Hokkaido-Open-Hardware/PSC-ONE/board/PSC-ONE_Neo/README.md

# PSC-ONE Neo

[Boards](../README.md) · [Project](../../README.md)

A planned successor to the PSC-ONE prototype, with the FPGA mounted directly on the PCB. Performance, memory and peripheral details remain design goals.

## Status

Under development. This directory does not yet provide a validated build and bring-up procedure.
