Hokkaido-Open-Hardware/PSC-ONE/board/PSC-Robot/README.md

# PSC-Robot

[Boards](../README.md) · [Project](../../README.md)

A planned robotics platform for motor control, sensing and PSC-ONE edge-AI demonstrations. The project overview includes the proposed balancing-robot demo.

## Status

Under development. This directory does not yet provide a validated build and bring-up procedure.
