Hokkaido-Open-Hardware/PSC-ONE/docs/images/PSC_RV32_V1_RTL.odp

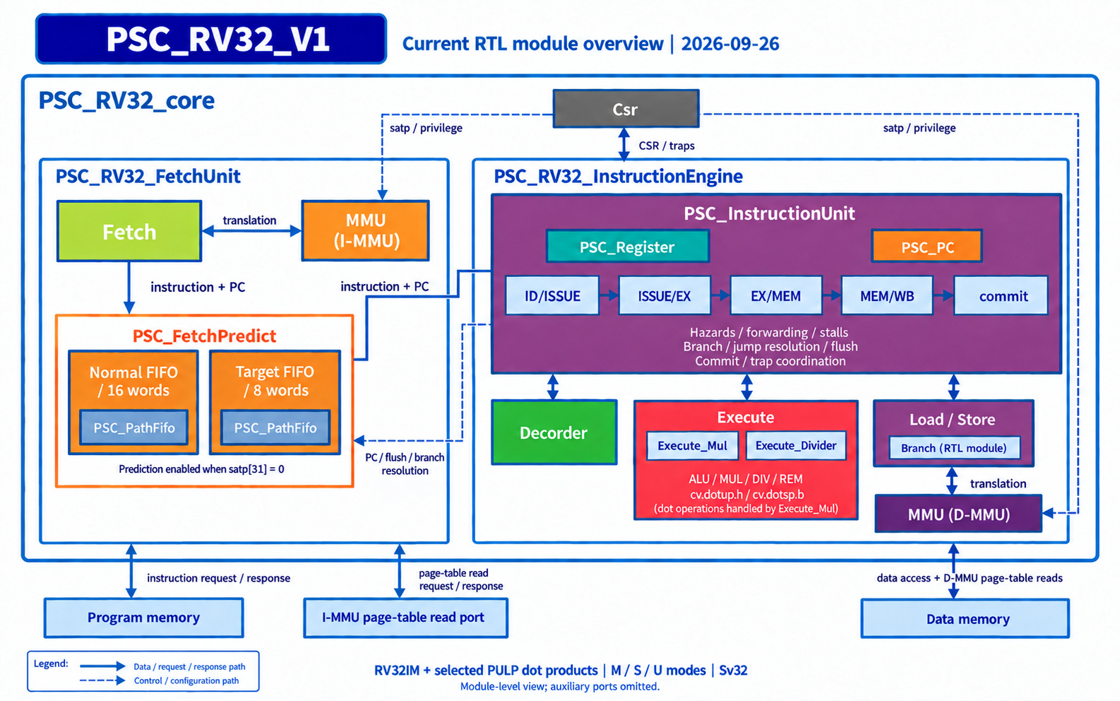
[picture p26: figure]
PSC_RV32_V1 current RTL module overview Original JPG embedded as a single image. Diagram labels and lines are not individually editable.
