Hokkaido-Open-Hardware/PSC-ONE/docs/PSC-ONE_SpecSheet.pdf

# PRELIMINARY

# PSC_ONE_Ver1.00

### PSC_ONE Chip Rev.1.00

Data Sheet
Rev.0.8 — Preliminary
QPSC Devices, Inc.
2026-06-02

4.5 2
目次

# PRELIMINARY

## 1 概要（Overview）

PSC_ONE は、QPSC-Design が開発するオープンソースのフルスタック RISC-V SoC プラットフォームである。 本システムは、独自開発の RV32ISP パイプライン CPU、Sv32 MMU、SDRAM コントローラ、キャッシュシステ ム、SD カードインタフェース、LCD コントローラ、および SynapEngine AI アクセラレータを単一アーキテクチャに 統合している。
PSC_ONE は専用 OS である PSC_OS を搭載し、SD カードからカーネルおよびユーザアプリケーションをロード して実行可能である。
ハードウェアとソフトウェアを一体開発できる教育・研究・組込み AI・ロボット制御向け SoC プラットフォームと して設計されている。

## 2 特長（Features）

- RV32ISP 32-bit RISC-V Pipeline CPU
- Sv32 MMU (Virtual Memory Support)
- PSC_OS Operating System
- SDR SDRAM Controller
- AXI4 Memory Infrastructure
- Data / Instruction Cache
- SD Card Boot Support (SPI Mode)
- SynapEngine AI Accelerator
- 2×2 INT8 Systolic Array
- UART Interface
- LCD Controller
- Memory Mapped I/O Architecture
- FPGA Verified Implementation

## 3 アプリケーション（Applications）

- Embedded AI Systems
- Edge Computing
- Robotics Control
- FPGA Education
- Operating System Research
- RISC-V Architecture Research
- AI Accelerator Development
- Computer Architecture Education

## 4 ブロック図（Block Diagram）

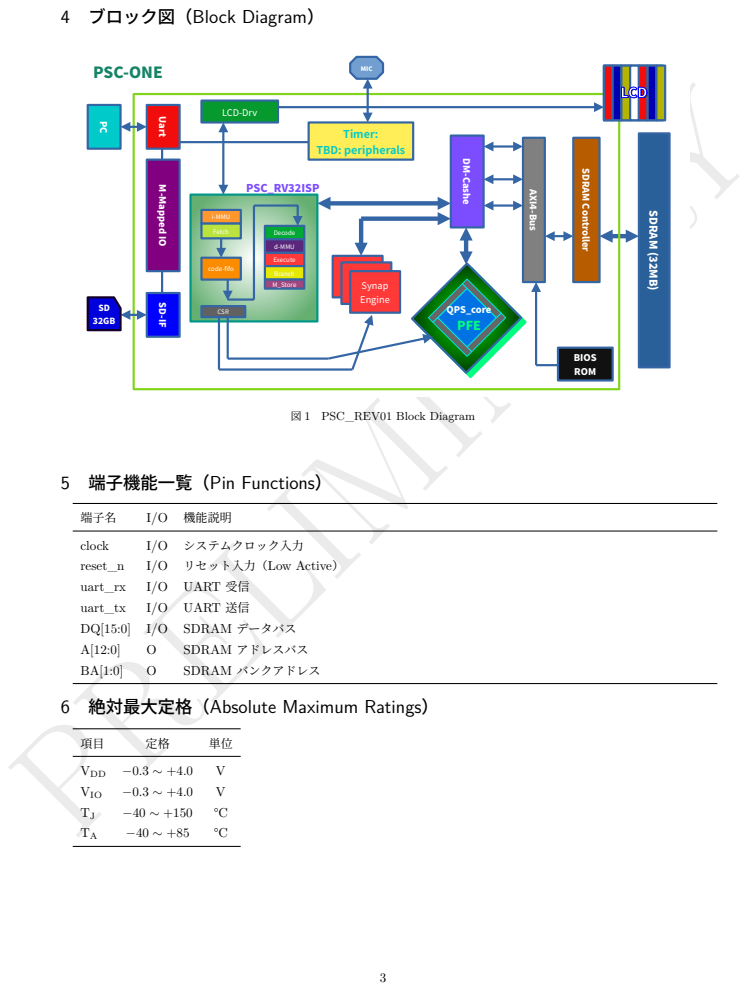
[picture p33: page 3]
PRELIMINARY PSC-ONE; t r olle; Fetch; Decode; Execute Branch M_Store; i-MMU; d-MMU; Synap Engine; AXI4-B; BIOS ROM; LCD-Drv; LCD LCD; code-fifo; PSC_RV32ISP; Timer: TBD: peripherals; CSR; MIC; QPS_core PFE; 図 1 PSC_REV01 Block Diagram; 端子名; I/O 機能説明; clock; I/O システムクロック入力; reset_n; I/O リセット入力（Low Active）; SDRAM アドレスバス; SDRAM バンクアドレス; VDD; VIO

5 端子機能一覧（Pin Functions）

uart_rx I/O UART 受信
uart_tx I/O UART 送信
DQ[15:0] I/O SDRAM データバス
6 絶対最大定格（Absolute Maximum Ratings）

# PRELIMINARY

## 7 推奨動作条件（Recommended Operating Conditions）

項目 | 最小 典型 | 最大
VDD | 3.0 | 3.3 | 3.6
VIO | 3.0 | 3.3 | 3.6
CLK 周波数 | – | – | 133 MHz
動作温度 TA | -40 | 25 | 85
Note: Conditions equivalent to Tang Nano 25K Primer.

## 8 電気的特性（Electrical Characteristics）

項目 | 最小 典型 | 最大
ICC（READ） | – | 60 80 mA
ICC（WRITE） – | 70 95 mA

## 9 発注情報（Ordering Information）

型番 | パッケージ
PSC1234-QFP48 48-pin QFP
PSC1234-BGA64 BGA64
