Hokkaido-Open-Hardware/PSC-ONE/ip/README.md

<p align="center">
  <a href="https://github.com/QPSC-Design/PSC-ONE">
    PSC-ONE Logo
  </a>
</p>

# Intellectual Property (IP)

[PSC-ONE](../README.md) · [Documentation](../docs/README.md)

This directory contains intellectual property related materials for the PSC-ONE project, including invention notes, prior art research, and patent draft documents.

At present, **two patent applications are planned** based on technologies developed within the PSC-ONE project.

The details of these applications have not yet been publicly disclosed.

Contents of this directory may be updated as development progresses and patent filings are completed.
