Hokkaido-Open-Hardware/PSC-ONE/board/PSC-ONE/README.md

# PSC-ONE Design

[PSC-ONE](../../README.md) · [Documentation](../../docs/README.md)

The current PSC-ONE prototype hardware.\

PSC-ONE board

<!-- contents -->
- [Purpose](#purpose)
- [Features](#features)
- [Getting Started](#getting-started)
- [License](#license)
<!-- /contents -->

## Purpose

PSC-ONE is a hardware evaluation and demonstration platform for the PSC project.

The board is designed to verify and validate the functionality of the PSC CPU, operating system, memory subsystem, peripherals, and AI acceleration technologies in a real hardware environment.

It also serves as a demonstration platform for various embedded applications, including:

- Voice recognition
- AI inference
- Graphics and display control
- Sensor integration
- Real-time embedded systems

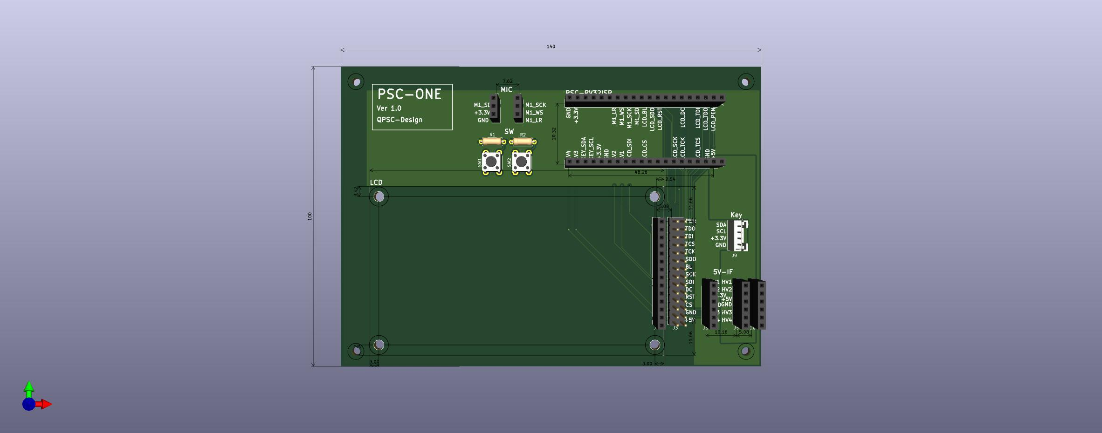
[picture p37: board/PSC-ONE/mechanical/PSC-ONE.3D_final.jpg]
PSC-ONE.3D final


## Features

- Custom PSC RISC-V CPU
- PSC-OS operating system support
- SDRAM memory interface
- LCD display interface
- Optional touch panel support
- SD card storage interface
- UART debugging console
- GPIO expansion
- AI accelerator integration support

## Getting Started

### Program the FPGA

Build the FPGA bitstream and program the PSC-ONE board using the Gowin Programmer.

After successful programming, connect:

* UART console
* SD card containing PSC-OS images
* LCD module (optional)

### Prepare the SD Card

Match the SD layout to the bootloader in the FPGA image. Two flows exist:

| Bootloader | SD layout |
| --- | --- |
| [FAT32 loader](../../software/os/src/boot/bootloader_fat32.c) | `KERNEL.MEM` and `USER.MEM` in the FAT32 root |
| [Legacy raw-image writer](../../hardware/bootloader/Makefile) | `kernel.img` at sector 100, `user.img` at sector 300 |

The raw-image writer currently hard-codes `/dev/sdc`; it does not accept a
`/dev/sdX` placeholder or automatically select a card. Inspect the actual device
and the selected bootloader before using that writer. The historical log below
belongs to the earlier raw-sector flow and is not a current layout specification.

Build the FAT32 bootloader from the repository root with the OS Makefile's
`fpga_fat32_boot` target (see that [Makefile](../../software/os/Makefile) for
available build targets and outputs).

### Boot PSC-OS

1. Insert the SD card into PSC-ONE.
2. Power on the board.
3. Open the UART console.

The bootloader loads:

1. `kernel.img` from the SD card into SDRAM
2. `user.img` from the SD card into SDRAM
3. Transfers control to PSC-OS

Historical boot log (June 2026; addresses and image sizes are build-dependent):

<details>
<summary>Show the full recorded boot log</summary>

```text
boot start

=== PSC random memory RW test start ===
[mem_check] range 00400000 - 00800000
[mem_check] access count=00000064
[mem_check] OK

=== PSC bootloader start ===
CTRL=0000000A
SD INIT start
LOAD: LBA=00000064 count=00000024 -> addr=00200000
RD[00000000] = 00256537
RD[00000004] = B1450513
RD[00000008] = 00050113
RD[0000000C] = 5000106F
RD[00000010] = 100005B7
RD[00000014] = 0085A603
RD[00000018] = 00167613
RD[0000001C] = 00060663
RD[00000020] = 00000013
RD[00000024] = FF1FF06F
RD[00000028] = 00A5A023
RD[0000002C] = 00008067
RD[00000030] = 100005B7
RD[00000034] = 0085A603
RD[00000038] = 00167613
RD[0000003C] = 00060663
WR[00000000] = 00256537
WR[00000004] = B1450513
WR[00000008] = 00050113
WR[0000000C] = 5000106F
WR[00000010] = 100005B7
WR[00000014] = 0085A603
WR[00000018] = 00167613
WR[0000001C] = 00060663
WR[00000020] = 00000013
WR[00000024] = FF1FF06F
WR[00000028] = 00A5A023
WR[0000002C] = 00008067
WR[00000030] = 100005B7
WR[00000034] = 0085A603
WR[00000038] = 00167613
WR[0000003C] = 00060663
  loaded sector 00000000 / 00000024
RD[00000000] = 04412883
RD[00000004] = 04812403
RD[00000008] = 04C12483
RD[0000000C] = 05012903
RD[00000010] = 05412983
RD[00000014] = 05812A03
RD[00000018] = 05C12A83
RD[0000001C] = 06012B03
RD[00000020] = 06412B83
RD[00000024] = 06812C03
RD[00000028] = 06C12C83
RD[0000002C] = 07012D03
RD[00000030] = 07412D83
RD[00000034] = 07812103
RD[00000038] = 10200073
RD[0000003C] = FCC10113
WR[00000000] = 04412883
WR[00000004] = 04812403
WR[00000008] = 04C12483
WR[0000000C] = 05012903
WR[00000010] = 05412983
WR[00000014] = 05812A03
WR[00000018] = 05C12A83
WR[0000001C] = 06012B03
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
002000d0: 93 85 65 d2 13 06 90 08  97 10 00 00 e7 80 80 6d  |..e............m|
002000e0: 6f 00 00 00 13 05 04 00  93 05 00 00 97 10 00 00  |o...............|
002000f0: e7 80 80 5a 13 05 04 00  83 20 c1 00 03 24 81 00  |...Z..... ...$..|
PSC_OS Boot Start.........
--- memset ---

+--------------------------------------------------+
|                    PSC_OS                        |
|            Minimal RISC-V Kernel Boot            |
+--------------------------------------------------+
| Build : Jun  6 2026 06:45:18
| CPU   : RV32 (Supervisor mode)
| MMU   : SV32
| UART  : SBI console or
| UART  : MMIO console
| CMD   : hello, primes, dump, sa_start
| quit  : Ctl+A C. q.
+--------------------------------------------------+
--- create_process_1 ---
---- kernel map start. ----
---- MMIO map start. ----
---- SA core address map start. ----
---- SA core data address map start. ----
---- SA core data wb address map start. ----
---- SD-Card IF address map start. ----
create_process_End
--- create_process_2 ---
---- kernel map start. ----
---- MMIO map start. ----
---- SA core address map start. ----
---- SA core data address map start. ----
---- SA core data wb address map start. ----
---- SD-Card IF address map start. ----
---- user image map start. ----
---- user stack map start. ----
create_process_End
--- yield ---
shell start.
PSC_OS> 

```

</details>

The `PSC_OS>` prompt indicates that this recorded run reached the shell.

## License

Hardware design files, schematics, PCB layouts, and related documentation are licensed under CERN-OHL-S v2.

Copyright (c) 2026 QPSC-Design
