Hokkaido-Open-Hardware/PSC-ONE/board/PSC-ONE_Neo/PSC_ONE_Neo_Board.jpg

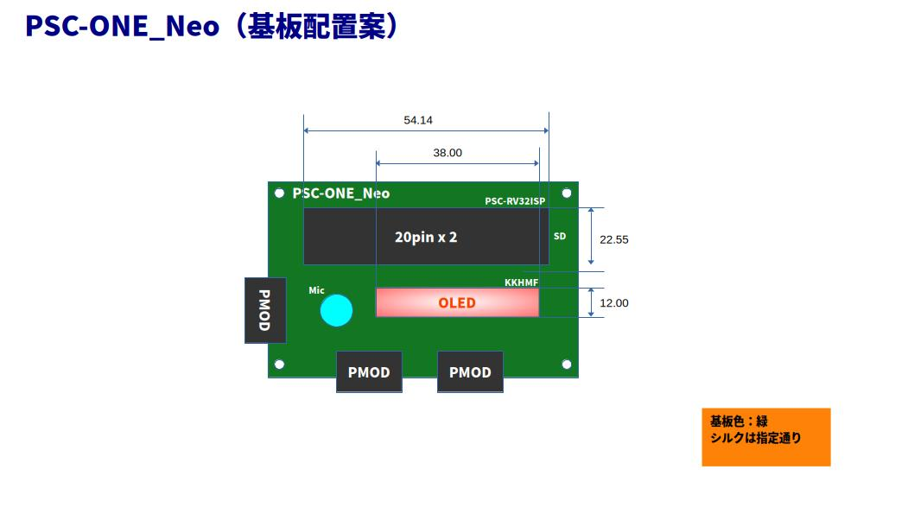
board/PSC-ONE_Neo/PSC_ONE_Neo_Board.jpg
