Hokkaido-Open-Hardware/PSC-ONE/docs/images/OMMF2026_exhibition_plan.jpg

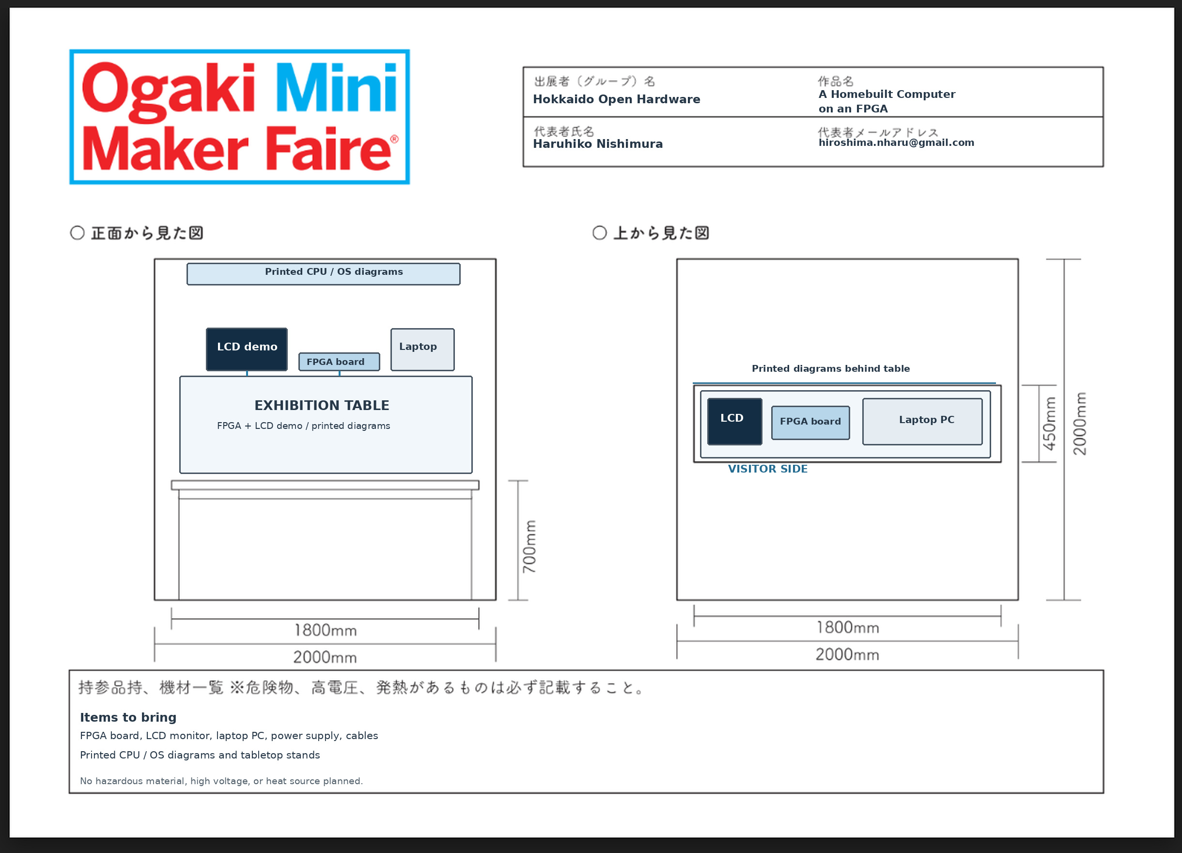
docs/images/OMMF2026_exhibition_plan.jpg
