Hokkaido-Open-Hardware/PSC-ONE/docs/images/PSC-ONE_RedBoard.png

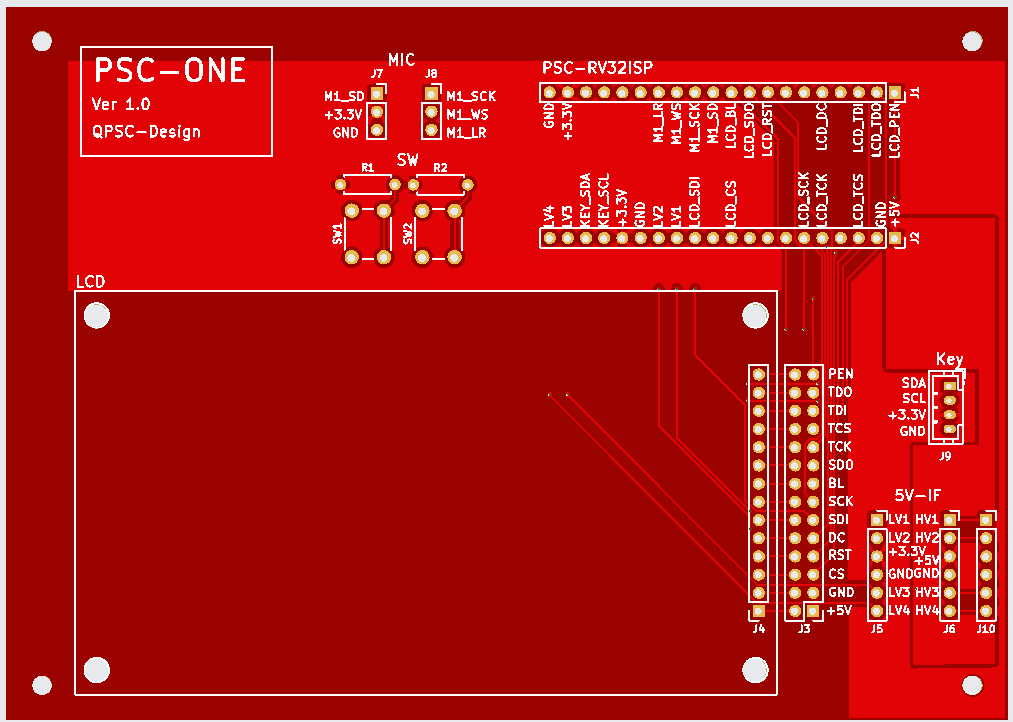
docs/images/PSC-ONE_RedBoard.png
