Hokkaido-Open-Hardware/PSC-ONE/docs/images/PSC_FPGA_SD_Card.jpg

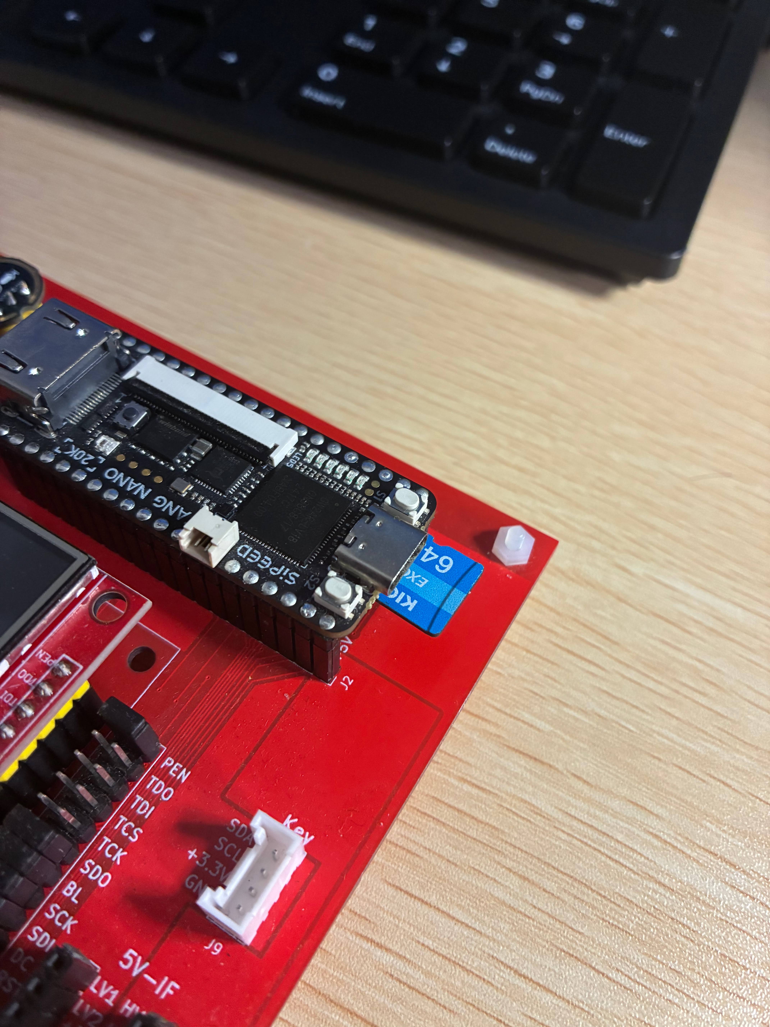
docs/images/PSC_FPGA_SD_Card.jpg
