Hokkaido-Open-Hardware/PSC-ONE/docs/images/PSC_LCD_Demo.jpg

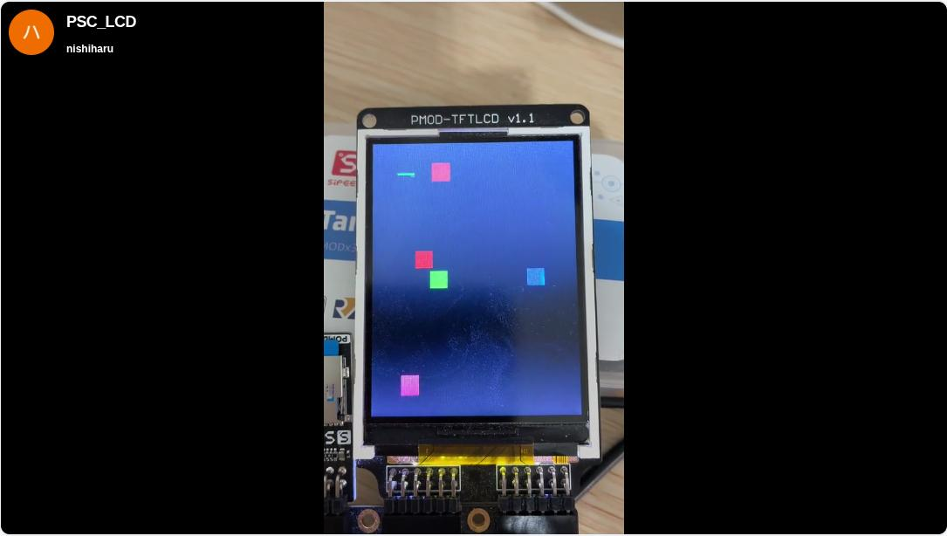
docs/images/PSC_LCD_Demo.jpg
