Hokkaido-Open-Hardware/PSC-ONE/docs/images/PSC_ONE_CPU_Block.jpg

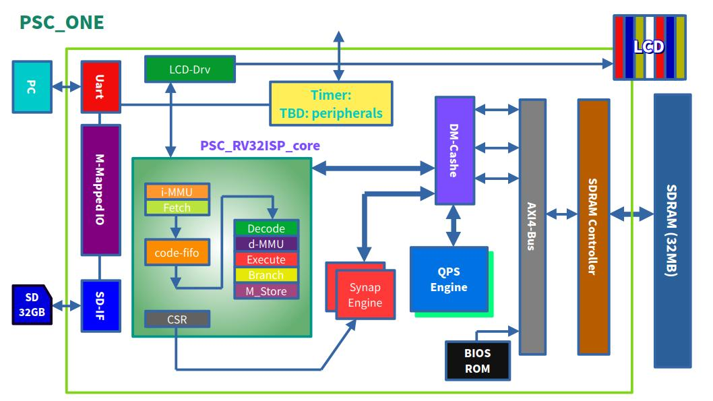
docs/images/PSC_ONE_CPU_Block.jpg
