Hokkaido-Open-Hardware/PSC-ONE/docs/images/PSC_ONE_DMA_Block.jpg

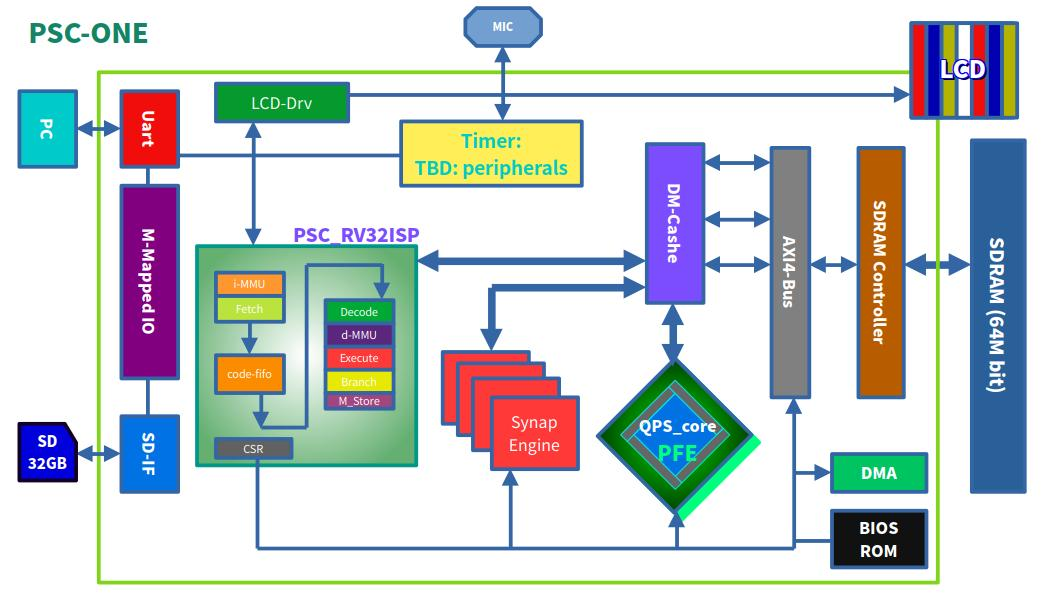
docs/images/PSC_ONE_DMA_Block.jpg
