Hokkaido-Open-Hardware/PSC-ONE/docs/images/PSC_ONE_voice_anime.png

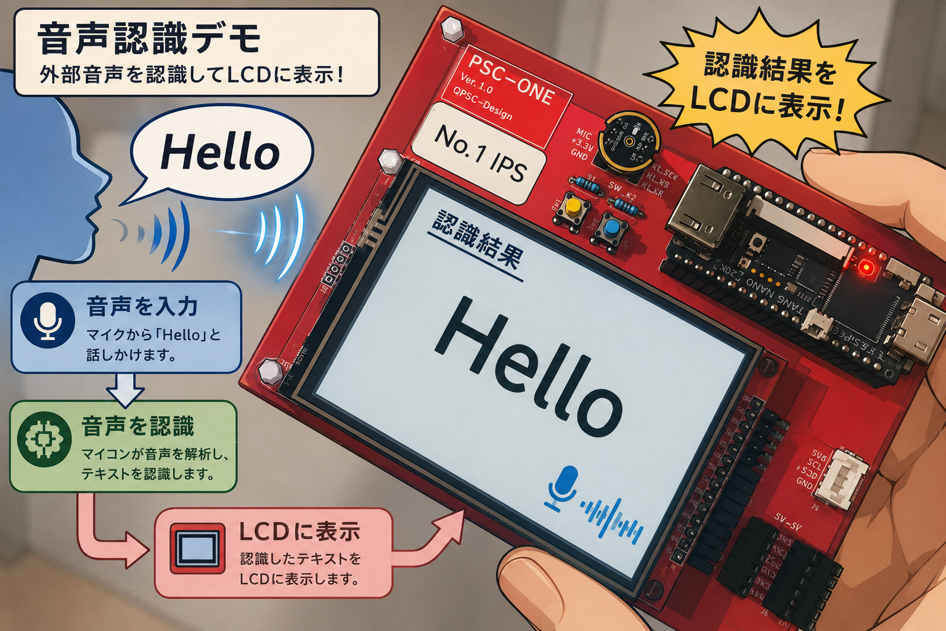
docs/images/PSC_ONE_voice_anime.png
