Hokkaido-Open-Hardware/PSC-ONE/docs/images/PSC_ONE_voice_anime_jp.png

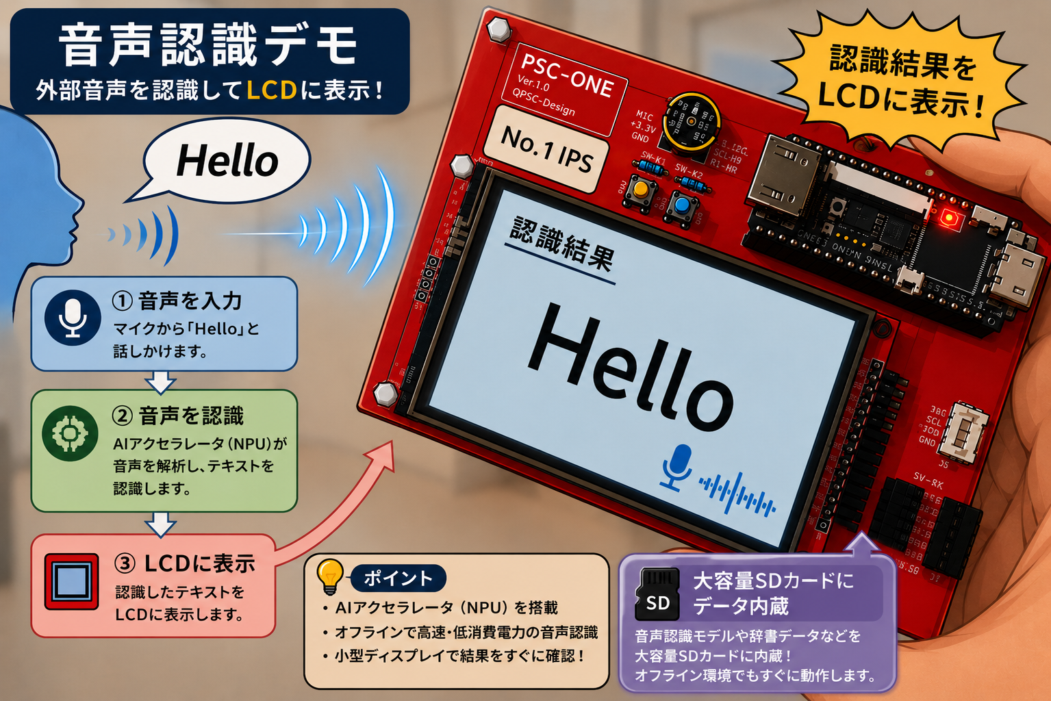
docs/images/PSC_ONE_voice_anime_jp.png
