Hokkaido-Open-Hardware/PSC-ONE/docs/images/PSC_SD_Boot.jpg

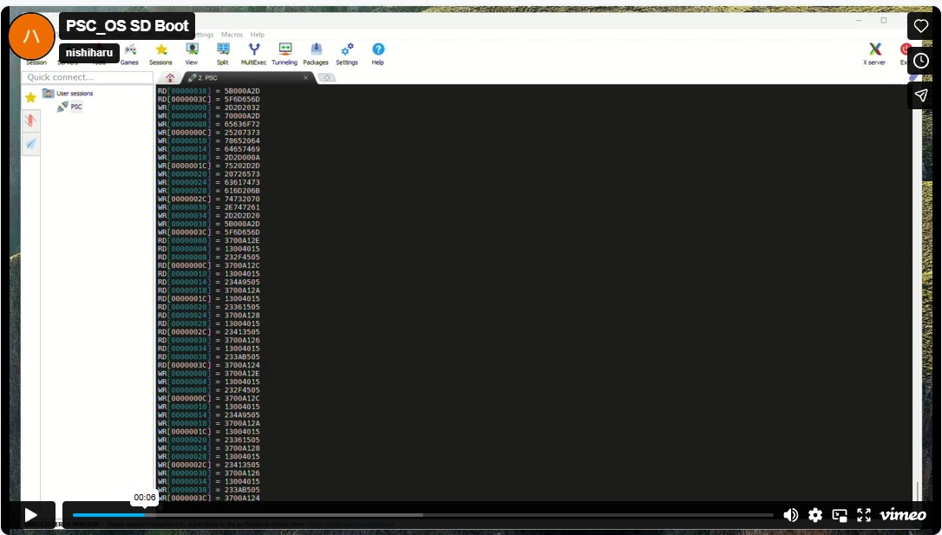
docs/images/PSC_SD_Boot.jpg
