Hokkaido-Open-Hardware/PSC-ONE/docs/PSC_OS.jpg

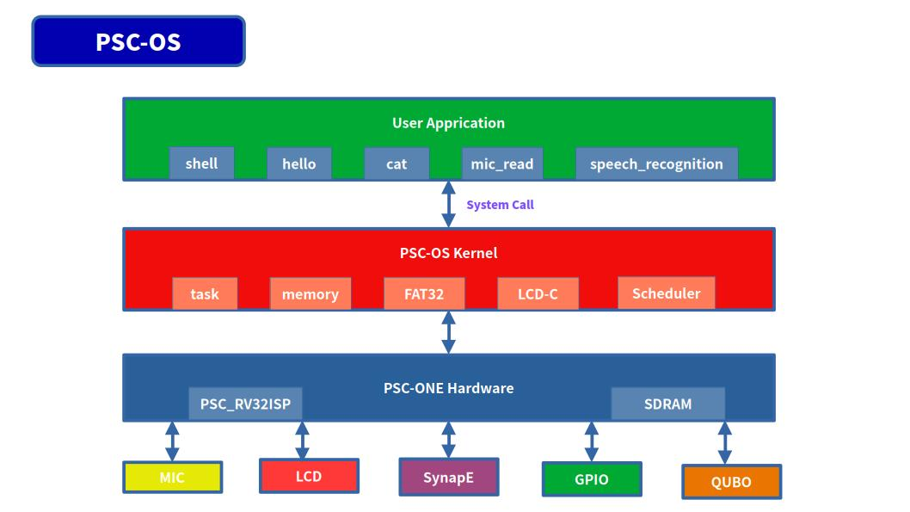
docs/PSC_OS.jpg
