Hokkaido-Open-Hardware/PSC-ONE/docs/PSC_OS_ChatGPT.png

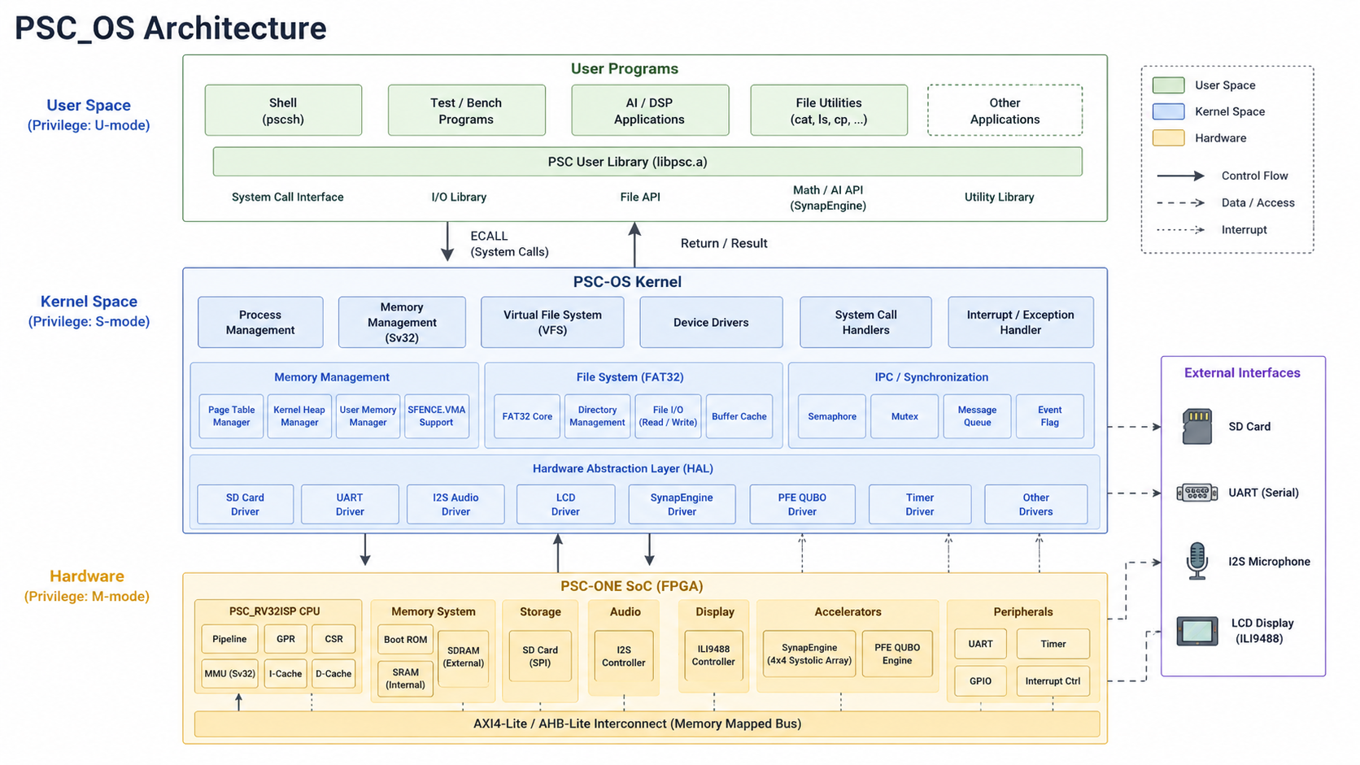
docs/PSC_OS_ChatGPT.png
