Hokkaido-Open-Hardware/PSC-ONE/hardware/rtl/soc/npu/docs/images/PSC_SynapEngine.jpg

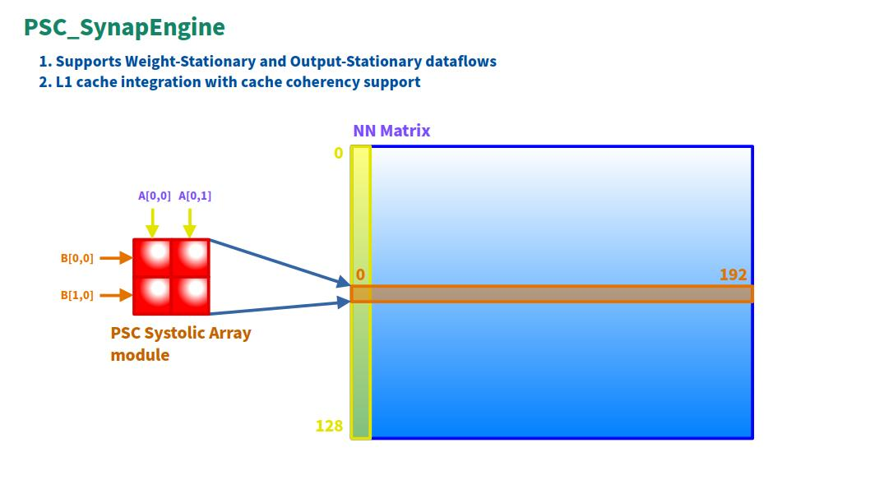
hardware/rtl/soc/npu/docs/images/PSC_SynapEngine.jpg
