Hokkaido-Open-Hardware/PSC-ONE/hardware/sim/log_yosys/yosys_cell_breakdown.png

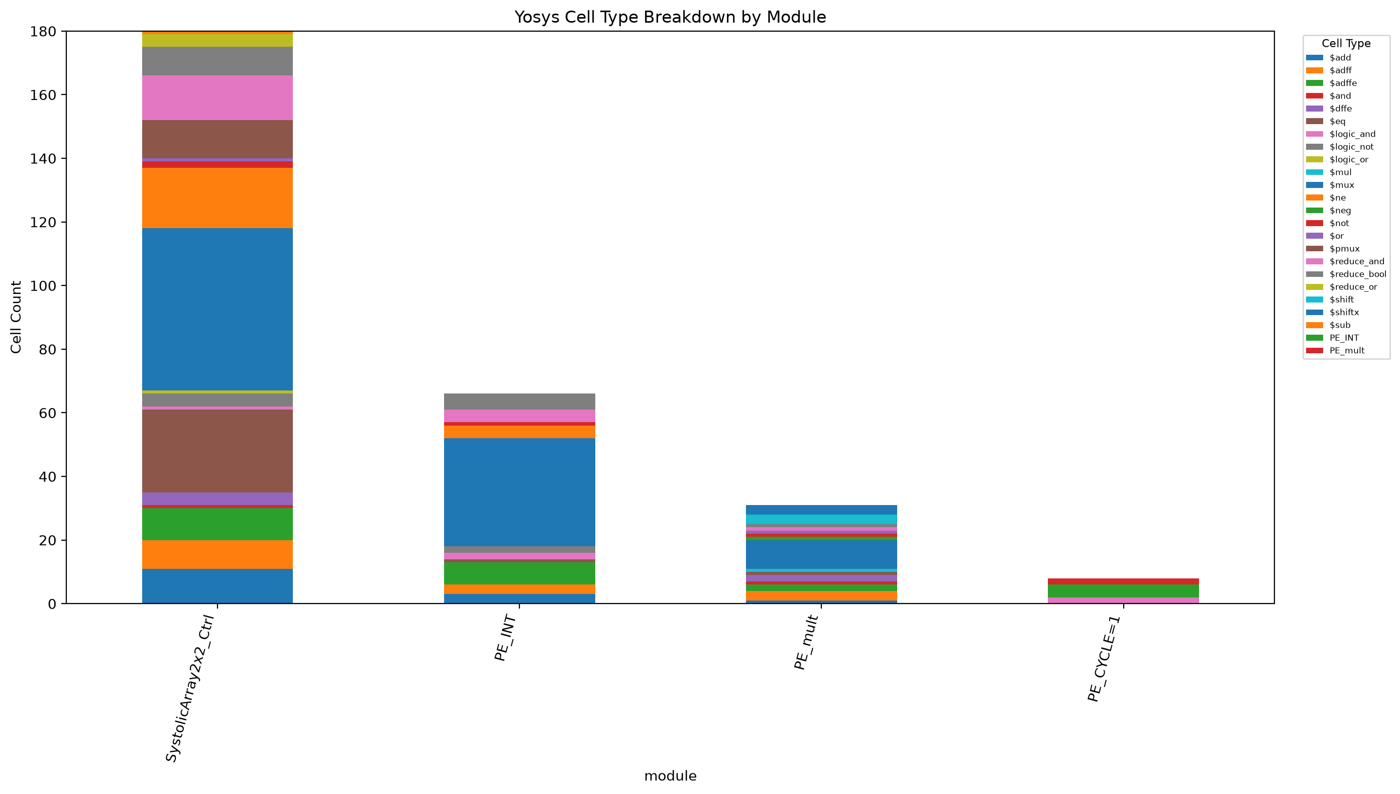
hardware/sim/log_yosys/yosys_cell_breakdown.png
