Hokkaido-Open-Hardware/PSC-ONE/hardware/sim/log_yosys/yosys_module_cells.png

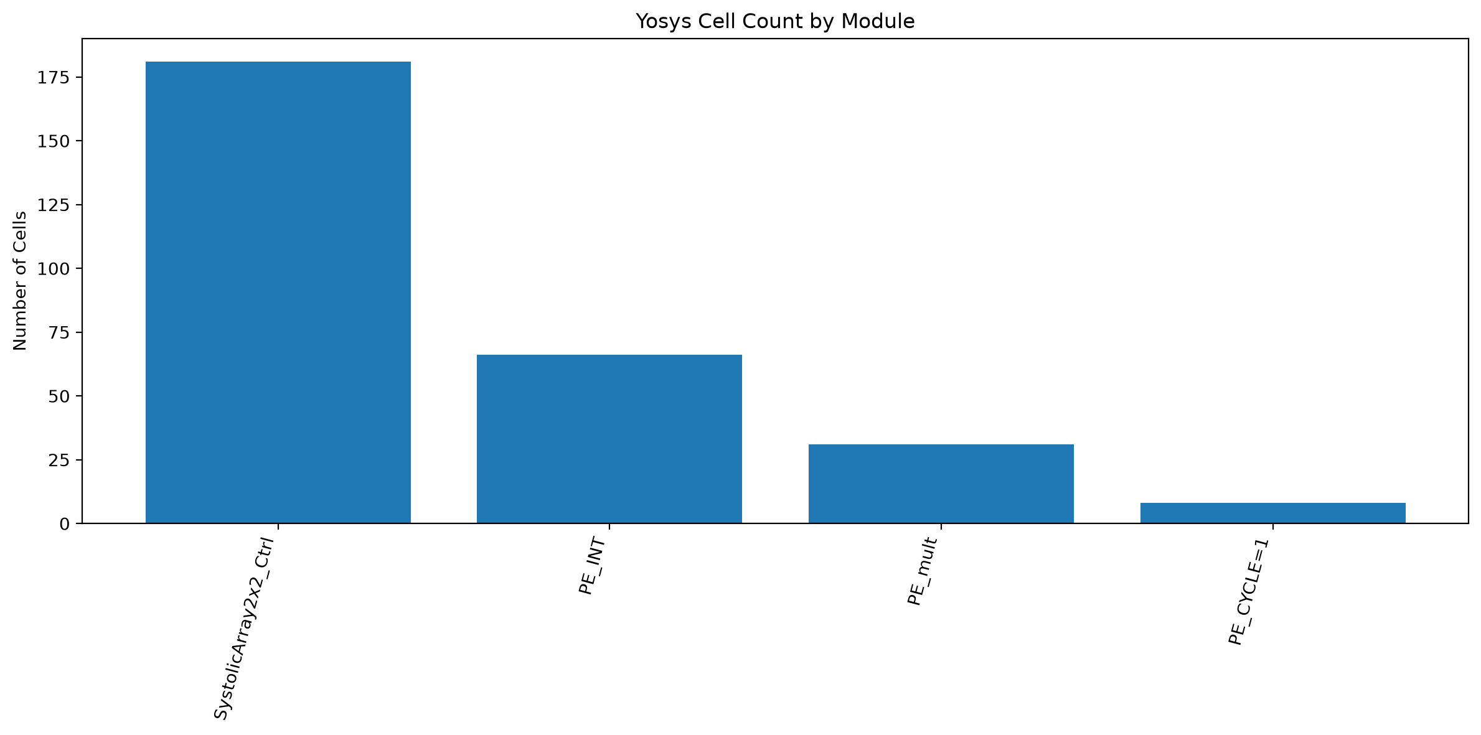
hardware/sim/log_yosys/yosys_module_cells.png
