Hokkaido-Open-Hardware/PSC-ONE/docs/getting-started.md

# Getting Started with PSC-ONE

This guide explains the basic steps required to build, simulate, and run **PSC-ONE** on a **Tang Nano 20K** FPGA board.

PSC-ONE is an experimental FPGA-based SoC consisting of a custom RISC-V CPU (**PSC_RV32**), PSC-OS, external SDRAM, peripherals, and the **PSC-NPU / SynapEngine** hardware accelerator.

The recommended procedure is:

1. Set up the simulation environment and confirm that the CPU tests pass.
2. Install Gowin EDA.
3. Create a Tang Nano 20K FPGA project and add the PSC-ONE RTL sources and CST constraints.
4. Compile the FPGA design.
5. Prepare an SD card containing `kernel.mem` and `user.mem`.
6. Connect a UART terminal.
7. Configure the Tang Nano 20K from Gowin EDA.
8. Confirm that PSC-OS boots.

The first goal is simply to get the following prompt:

```text
PSC_OS>
```

---

# 1. Requirements

## Hardware

The minimum hardware required to run PSC-ONE is:

* Tang Nano 20K FPGA board
* USB cable
* microSD card
* PC for Gowin EDA and UART communication

Additional peripherals such as the I2S microphone and LCD are not required for the initial boot test.

## Software

The development environment requires:

* Git
* Make
* Verilator
* Python 3
* cocotb
* RISC-V GCC toolchain
* Gowin EDA
* UART terminal software

A Linux environment is recommended for simulation and software development.

Gowin EDA can be used to synthesize, place-and-route, generate the FPGA bitstream, and configure the Tang Nano 20K.

---

# 2. Get the Source Code

Clone the PSC-ONE repository:

```bash
git clone https://github.com/QPSC-Design/PSC-ONE.git
cd PSC-ONE
```

The important directories are approximately:

```text
PSC-ONE/
├── docs/
├── hardware/
│   ├── rtl/
│   │   └── top/
│   │       └── PSC_ONE_Chip.v
│   └── sim/
├── software/
│   └── os/
└── README.md
```

The top-level FPGA design is:

```text
hardware/rtl/top/PSC_ONE_Chip.v
```

PSC-ONE is primarily implemented in Verilog/SystemVerilog.

---

# 3. Set Up the Simulation Environment

Before using the FPGA board, first confirm that the PSC_RV32 CPU operates correctly in simulation.

Move to the simulation directory:

```bash
cd hardware/sim
```

Set up the environment required by the `Makefile.cpu` family of tests.

The simulation environment uses tools such as:

```text
Verilator
Python
cocotb
RISC-V GCC toolchain
Make
```

Run the CPU tests provided by the `Makefile.cpu` environment.

The exact target may depend on the current version of the repository, so check the available targets in `Makefile.cpu` and related Makefiles.

The important point at this stage is that the CPU test suite completes successfully with:

```text
PASS
```

Do not proceed to FPGA debugging until the basic CPU tests pass in simulation.

This separates RTL/software problems from FPGA board, pin assignment, SD card, and UART problems.

---

# 4. Run PSC-OS in Simulation

It is also recommended to confirm that PSC-OS boots in RTL simulation before programming the FPGA.

From:

```text
hardware/sim
```

run:

```bash
make -f Makefile.pscos simulate_PSCOS SIM_FAST=1
```

A successful boot should eventually display:

```text
PSC_OS>
```

If this works, the CPU, memory subsystem, boot sequence, and PSC-OS are operating together in simulation.

---

# 5. Install Gowin EDA

Download and install **Gowin EDA** from Gowin Semiconductor.

PSC-ONE currently targets the FPGA used on the **Tang Nano 20K** board.

Gowin EDA is used for:

```text
RTL
 |
 v
Synthesis
 |
 v
Place & Route
 |
 v
Bitstream Generation
 |
 v
Tang Nano 20K
```

Confirm that Gowin EDA and Gowin Programmer can start correctly before creating the FPGA project.

---

# 6. Create the FPGA Project

Create a new Gowin EDA project targeting the FPGA device used by the Tang Nano 20K.

The PSC-ONE top-level module is:

```text
hardware/rtl/top/PSC_ONE_Chip.v
```

Set `PSC_ONE_Chip` as the top-level design.

## Add RTL Sources

Add `PSC_ONE_Chip.v` and all RTL modules instantiated below it to the Gowin EDA project.

In other words, Gowin EDA must be able to resolve the complete hierarchy starting from:

```text
PSC_ONE_Chip
```

including the CPU, memory controller, peripherals, and other modules used by the current PSC-ONE configuration.

The hierarchy is conceptually:

```text
PSC_ONE_Chip
      |
      +-- PSC_RV32 CPU
      |
      +-- Memory / SDRAM
      |
      +-- UART
      |
      +-- SD interface
      |
      +-- Timers / peripherals
      |
      +-- PSC-NPU / SynapEngine
      |
      +-- other required RTL modules
```

Make sure that all required `.v` and `.sv` source files are registered in the Gowin EDA project.

If Gowin reports an unresolved or undefined module during synthesis, check whether the corresponding RTL source file has been added to the project.

## Configure the PLL

PSC-ONE requires a PLL generated by **Gowin EDA**.

The PLL instance used by the FPGA design is referenced from:

```text
hardware/rtl/top/PSC_ONE_Chip.v
```

The PLL IP must be created in the Gowin EDA project before the design can be synthesized successfully.

For the **Tang Nano 20K**, configure the PLL with the following clock frequencies:

```text
Input clock  : 27 MHz
System clock : 80 MHz
```

The 27 MHz clock provided by the Tang Nano 20K is used as the PLL reference clock, and the PLL generates the **80 MHz PSC-ONE system clock**.

The basic clock structure is:

```text
Tang Nano 20K
   27 MHz
      |
      v
  Gowin PLL
      |
      +------> 80 MHz System Clock
      |
      +------> SDRAM Clock
```

### SDRAM Clock Phase

The SDRAM clock must use a phase shift relative to the main PSC-ONE system clock.

The required phase setting is documented in the comments inside:

```text
hardware/rtl/top/PSC_ONE_Chip.v
```

When configuring the PLL in Gowin EDA, set the SDRAM clock output phase according to the value specified in those comments.

Do not simply use the same phase as the 80 MHz system clock.

The intended clock relationship is:

```text
27 MHz input
     |
     v
  Gowin PLL
     |
     +---- 80 MHz ----> PSC-ONE logic
     |
     +---- 80 MHz
           + phase shift ----> SDRAM
```

The phase shift is required to provide the appropriate timing relationship between the FPGA logic and the external SDRAM.

Because the required phase may change together with the RTL implementation, **`PSC_ONE_Chip.v` should be treated as the authoritative source for the SDRAM phase setting**.

### Add the PLL to the Gowin Project

After generating the PLL IP in Gowin EDA:

1. Add the generated PLL module to the FPGA project.
2. Make sure the module name and ports match the PLL instance in `PSC_ONE_Chip.v`.
3. Confirm that the PLL input is configured for **27 MHz**.
4. Confirm that the PSC-ONE system clock output is **80 MHz**.
5. Configure the SDRAM clock output with the phase shift specified in the comments in `PSC_ONE_Chip.v`.

If the PLL module is missing or incorrectly configured, Gowin synthesis may fail, or PSC-ONE may compile but fail to operate correctly on the FPGA.

## Prepare the FPGA Boot ROM Files

When booting PSC-ONE on the FPGA, the BootLoader ROM in:

```text
hardware/rtl/.../PSC_ONE_Boot_axi.v
```

must use the FAT32 bootloader image.

In `PSC_ONE_Boot_axi.v`, locate the BootLoader ROM module:

```verilog
//------- BootLoader ROM module -------
// bootloader.mem
module boot_loader_rom #(
    parameter integer ADDR_WIDTH = 13
)(
    input  wire                  clock,
    input  wire [ADDR_WIDTH-1:0] addr,
    output reg  [31:0]           dout
);
    localparam integer ROM_WORD = 4500;  // 固定値にしないとFPGA内でROMと認識されない.
    reg [31:0] Boot_Loader_rom [0:ROM_WORD-1];
    initial $readmemh("mem/bootloader.mem", Boot_Loader_rom);

    always @(posedge clock) begin
        if (addr > ROM_WORD)
            dout <= 32'd0;
        else
            dout <= Boot_Loader_rom[addr];
    end
endmodule
```

and change the ROM initialization file from:

```verilog
initial $readmemh("mem/bootloader.mem", Boot_Loader_rom);
```

to:

```verilog
initial $readmemh("mem/bootloader_fat32.mem", Boot_Loader_rom);
```

The FPGA build must therefore use `bootloader_fat32.mem`, not `bootloader.mem`, for the BootLoader ROM.

### Generate `bootloader_fat32.mem` and `bootrom.mem`

The required FPGA boot ROM files are generated under:

```text
hardware/bootloader/
```

Move to that directory and use its `Makefile` to generate the boot images:

```bash
cd hardware/bootloader
make bootloader_fat32 
```

Confirm that the build produces at least:

```text
bootloader_fat32.mem
bootrom.mem
```

These files are part of the FPGA boot configuration and must be generated before compiling the Gowin project.

### Generate `kernel.mem` and `user.mem`

The required PSC-OS files are generated in:

```text
hardware/firmware/
```

Navigate to the directory and use the `Makefile` to generate the boot images:

```bash
cd hardware/firmware
make firmware_fat32
```

After the build completes, copy `./mem/kernel.mem` and `./mem/user.mem` to the root directory of the FAT32-formatted SD card.

### Add the Boot ROM Files to the Gowin Project

Register the generated files in the FPGA project so that Gowin EDA can find them during synthesis:

```text
bootloader_fat32.mem
bootrom.mem
```

Also make sure the project file layout or search path matches the paths used by `$readmemh(...)` in the RTL. In particular, `PSC_ONE_Boot_axi.v` must be able to resolve:

```text
mem/bootloader_fat32.mem
```

If the `.mem` file is missing or the path does not match, synthesis may succeed incorrectly or the FPGA may fail to boot PSC-OS.

## Add the CST File

Add the PSC-ONE **CST constraint file** to the Gowin EDA project.

The CST file defines the FPGA pin assignments and I/O configuration required by the Tang Nano 20K board.

Without the correct CST constraints, interfaces such as UART, SD card, SDRAM, LEDs, and other external signals will not be connected to the correct FPGA pins.

Make sure the CST file matches the current PSC-ONE hardware configuration.

---

# 7. Compile PSC-ONE with Gowin EDA

After registering the RTL source files and CST constraints, compile the project in Gowin EDA.

The normal process is:

```text
PSC_ONE_Chip.v
       |
       v
   Synthesis
       |
       v
Place & Route
       |
       v
Bitstream Generation
```

Check the Gowin EDA output for errors.

Warnings may exist, but synthesis and place-and-route must complete successfully before programming the FPGA.

It is also useful to check the timing report and confirm that the generated design satisfies the clock requirements of the current PSC-ONE configuration.

After successful compilation, Gowin EDA generates the bitstream used to configure the FPGA.

---

# 8. Prepare the SD Card

PSC-ONE loads its software from a microSD card.

Prepare a microSD card and format it as:

```text
FAT32
```

Copy the following files to the **root directory** of the SD card:

```text
kernel.mem
user.mem
```

The SD card should therefore look approximately like:

```text
/
├── kernel.mem
└── user.mem
```

Additional files can be added later for PSC-OS and MicroPython experiments.

Insert the prepared microSD card into the Tang Nano 20K before booting PSC-ONE.

The names and locations of `kernel.mem` and `user.mem` are important because the PSC-ONE boot process expects to find these files on the FAT32 filesystem.

---

# 9. Connect the UART Terminal

PSC-OS uses UART as its primary console.

Connect the Tang Nano 20K to the PC and start a UART terminal application.

On Windows, any standard serial terminal application capable of communicating with the board's UART can be used.

Select the COM port corresponding to the Tang Nano 20K UART interface and configure the terminal using the UART settings required by the current PSC-ONE build.

If no output appears after configuring the FPGA, first check:

* Correct COM port
* UART settings
* USB connection
* FPGA configuration
* SD card
* `kernel.mem`
* `user.mem`

Keep the UART terminal open while configuring or resetting the FPGA so that the boot messages can be observed.

---

# 10. Configure the Tang Nano 20K

Connect the Tang Nano 20K to the PC through USB.

Open **Gowin Programmer** from Gowin EDA.

Select the bitstream generated by the FPGA compilation process and configure the Tang Nano 20K.

The complete procedure is:

```text
Run CPU simulation tests
          |
          v
       PASS
          |
          v
Install Gowin EDA
          |
          v
Create Tang Nano 20K project
          |
          v
Add PSC_ONE_Chip.v
and dependent RTL sources
          |
          v
Add CST constraints
          |
          v
Synthesis
          |
          v
Place & Route
          |
          v
Generate Bitstream
          |
          v
Prepare FAT32 SD card
          |
          +-- kernel.mem
          |
          +-- user.mem
          |
          v
Open UART terminal
          |
          v
Configure Tang Nano 20K
          |
          v
       PSC-OS
```

After configuration, PSC-ONE should begin executing on the FPGA.

---

# 11. Confirm PSC-OS Boot

Watch the UART terminal.

If PSC-ONE boots successfully, the PSC-OS shell prompt should appear:

```text
PSC_OS>
```

Try the `hello` command:

```text
PSC_OS> hello
```

Expected output:

```text
Hello world from shell!
```

At this point, the complete basic PSC-ONE system is running:

```text
Tang Nano 20K
      |
      v
PSC-ONE FPGA SoC
      |
      v
PSC_RV32 RISC-V CPU
      |
      v
    PSC-OS
      |
      v
 UART Shell
```

This confirms that the FPGA configuration, custom RISC-V CPU, memory subsystem, SD-card boot path, and PSC-OS are working together.

---

# 12. Start MicroPython

PSC-OS includes a minimal MicroPython environment.

From the PSC-OS shell:

```text
PSC_OS> micropython
```

The MicroPython REPL should start.

For example:

```python
>>> 1 + 2
3
```

PSC-ONE also provides the `psc` module:

```python
>>> import psc
```

The module provides access to PSC-ONE hardware and PSC-OS services.

For example:

```python
psc.fat32_ls()
psc.led_on()
psc.led_off()
psc.sa_run(...)
psc.timer_start(...)
psc.timer_stop(...)
```

This makes it possible to control FPGA hardware directly from MicroPython running on the custom PSC_RV32 CPU.

---

# 13. Troubleshooting

If PSC-ONE does not boot, check the system step by step rather than debugging everything at once.

## CPU simulation fails

Confirm that:

* Verilator is installed.
* Python and cocotb are installed.
* The RISC-V toolchain is available.
* The required environment variables and paths are configured.
* The `Makefile.cpu` tests pass.

## Gowin synthesis fails

Check that:

* `PSC_ONE_Chip.v` is set as the top-level design.
* All instantiated RTL modules are registered in the project.
* Both `.v` and `.sv` files required by the design are included.
* The correct CST file is registered.
* The correct Tang Nano 20K FPGA device is selected.

## FPGA configures but PSC-OS does not start

Check:

* SD card is inserted.
* SD card is FAT32 formatted.
* `kernel.mem` exists in the root directory.
* `user.mem` exists in the root directory.
* The correct FPGA bitstream was programmed.
* UART is connected to the correct COM port.
* UART settings match PSC-ONE.

## UART output is unreadable

Incorrect UART settings are a common cause of garbled output.

Check the baud rate and other serial settings against the current PSC-ONE RTL configuration.

---

# 14. Where to Go Next

Once the basic system is running, PSC-ONE can be explored at several levels.

**CPU**

Study and modify the PSC_RV32 RISC-V CPU implementation under:

```text
hardware/rtl/
```

**Simulation**

Run and modify the Verilator/cocotb test environment under:

```text
hardware/sim/
```

**Operating System**

Explore PSC-OS under:

```text
software/os/
```

**MicroPython**

Start MicroPython from PSC-OS and experiment with the `psc` module.

**SynapEngine / PSC-NPU**

Use the hardware matrix accelerator and compare its execution with software running on PSC_RV32.

**Peripherals**

PSC-ONE also provides interfaces for experimenting with hardware such as:

* SD card / FAT32
* I2S microphone
* SPI LCD
* timers
* UART
* SynapEngine / PSC-NPU

---

# PSC-ONE

PSC-ONE is intended as an experimental platform for exploring the complete stack of a small computer system:



```text
Application
     |
     v
MicroPython / C
     |
     v
   PSC-OS
     |
     v
PSC_RV32 RISC-V CPU
     |
     v
FPGA SoC + Hardware Accelerators
     |
     v
Tang Nano 20K
```

The CPU, operating system, peripherals, and hardware accelerators are developed together.

Once the `PSC_OS>` prompt appears on the UART terminal, the basic PSC-ONE environment is ready for experimentation.
