Hokkaido-Open-Hardware/PSC-ONE/hardware/rtl/soc/npu_v2/results/int8_quantization.csv

original_weight | code | quantized_weight | absolute_error
-128 | 238 | -128 | 0
-127 | 15 | -127 | 0
-126 | 31 | -126 | 0
-125 | 47 | -124 | 1
-124 | 47 | -124 | 0
-123 | 47 | -124 | 1
-122 | 63 | -120 | 2
-121 | 63 | -120 | 1
-120 | 63 | -120 | 0
-119 | 63 | -120 | 1
-118 | 63 | -120 | 2
-117 | 63 | -120 | 3
-116 | 79 | -112 | 4
-115 | 79 | -112 | 3
-114 | 79 | -112 | 2
-113 | 79 | -112 | 1
-112 | 79 | -112 | 0
-111 | 79 | -112 | 1
-110 | 79 | -112 | 2
-109 | 79 | -112 | 3
-108 | 79 | -112 | 4
-107 | 79 | -112 | 5
-106 | 79 | -112 | 6
-105 | 79 | -112 | 7
-104 | 95 | -96 | 8
-103 | 95 | -96 | 7
-102 | 95 | -96 | 6
-101 | 95 | -96 | 5
-100 | 95 | -96 | 4
-99 | 95 | -96 | 3
-98 | 95 | -96 | 2
-97 | 95 | -96 | 1
-96 | 95 | -96 | 0
-95 | 95 | -96 | 1
-94 | 95 | -96 | 2
-93 | 95 | -96 | 3
-92 | 95 | -96 | 4
-91 | 95 | -96 | 5
-90 | 95 | -96 | 6
-89 | 95 | -96 | 7
-88 | 206 | -80 | 8
-87 | 206 | -80 | 7
-86 | 206 | -80 | 6
-85 | 206 | -80 | 5
-84 | 206 | -80 | 4
-83 | 206 | -80 | 3
-82 | 206 | -80 | 2
-81 | 206 | -80 | 1
-80 | 206 | -80 | 0
-79 | 206 | -80 | 1
-78 | 206 | -80 | 2
-77 | 206 | -80 | 3
-76 | 190 | -72 | 4
-75 | 190 | -72 | 3
-74 | 190 | -72 | 2
-73 | 190 | -72 | 1
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
