Hokkaido-Open-Hardware/PSC-ONE/hardware/rtl/soc/npu_v2/results/model_comparison.csv

sample | layer | channel | original_acc | pot_acc | original_output | pot_output | absolute_error
0 | 0 | 0 | 1380 | 1380 | 127 | 127 | 0
0 | 0 | 1 | 797 | 797 | 83 | 83 | 0
0 | 0 | 2 | -596 | -596 | -17 | -17 | 0
0 | 0 | 3 | -2514 | -2514 | -17 | -17 | 0
0 | 0 | 4 | -1552 | -1552 | -17 | -17 | 0
0 | 0 | 5 | -920 | -920 | -17 | -17 | 0
0 | 0 | 6 | 2472 | 2472 | 127 | 127 | 0
0 | 0 | 7 | 2489 | 2489 | 127 | 127 | 0
0 | 0 | 8 | 1411 | 1411 | 127 | 127 | 0
0 | 0 | 9 | -417 | -417 | -17 | -17 | 0
0 | 0 | 10 | -2365 | -2365 | -17 | -17 | 0
0 | 0 | 11 | -2363 | -2363 | -17 | -17 | 0
0 | 0 | 12 | -1251 | -1251 | -17 | -17 | 0
0 | 0 | 13 | 716 | 716 | 73 | 73 | 0
0 | 0 | 14 | 2653 | 2653 | 127 | 127 | 0
0 | 0 | 15 | 1665 | 1665 | 127 | 127 | 0
0 | 1 | 0 | -695 | -695 | -36 | -36 | 0
0 | 1 | 1 | 322 | 322 | 27 | 27 | 0
0 | 1 | 2 | 169 | 169 | 18 | 18 | 0
0 | 1 | 3 | 16 | 16 | 8 | 8 | 0
1 | 0 | 0 | 363 | 363 | 29 | 29 | 0
1 | 0 | 1 | 132 | 132 | 0 | 0 | 0
1 | 0 | 2 | -99 | -99 | -17 | -17 | 0
1 | 0 | 3 | -330 | -330 | -17 | -17 | 0
1 | 0 | 4 | -561 | -561 | -17 | -17 | 0
1 | 0 | 5 | -792 | -792 | -17 | -17 | 0
1 | 0 | 6 | 852 | 852 | 90 | 90 | 0
1 | 0 | 7 | 621 | 621 | 61 | 61 | 0
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
