Hokkaido-Open-Hardware/PSC-ONE/hardware/rtl/soc/npu_v2/results/model_weights.csv

layer | index | original_weight | code | quantized_weight | absolute_error
0 | 0 | -4 | 43 | -4 | 0
0 | 1 | 3 | 1 | 3 | 0
0 | 2 | -5 | 138 | -5 | 0
0 | 3 | 2 | 41 | 2 | 0
0 | 4 | -6 | 27 | -6 | 0
0 | 5 | 1 | 24 | 1 | 0
0 | 6 | -7 | 11 | -7 | 0
0 | 7 | 0 | 0 | 0 | 0
0 | 8 | 7 | 56 | 7 | 0
0 | 9 | -1 | 9 | -1 | 0
0 | 10 | 6 | 18 | 6 | 0
0 | 11 | -2 | 26 | -2 | 0
0 | 12 | 5 | 2 | 5 | 0
0 | 13 | -3 | 10 | -3 | 0
0 | 14 | 4 | 17 | 4 | 0
0 | 15 | -4 | 43 | -4 | 0
0 | 16 | -2 | 26 | -2 | 0
0 | 17 | 5 | 2 | 5 | 0
0 | 18 | -3 | 10 | -3 | 0
0 | 19 | 4 | 17 | 4 | 0
0 | 20 | -4 | 43 | -4 | 0
0 | 21 | 3 | 1 | 3 | 0
0 | 22 | -5 | 138 | -5 | 0
0 | 23 | 2 | 41 | 2 | 0
0 | 24 | -6 | 27 | -6 | 0
0 | 25 | 1 | 24 | 1 | 0
0 | 26 | -7 | 11 | -7 | 0
0 | 27 | 0 | 0 | 0 | 0
0 | 28 | 7 | 56 | 7 | 0
0 | 29 | -1 | 9 | -1 | 0
0 | 30 | 6 | 18 | 6 | 0
0 | 31 | -2 | 26 | -2 | 0
0 | 32 | 0 | 0 | 0 | 0
0 | 33 | 7 | 56 | 7 | 0
0 | 34 | -1 | 9 | -1 | 0
0 | 35 | 6 | 18 | 6 | 0
0 | 36 | -2 | 26 | -2 | 0
0 | 37 | 5 | 2 | 5 | 0
0 | 38 | -3 | 10 | -3 | 0
0 | 39 | 4 | 17 | 4 | 0
0 | 40 | -4 | 43 | -4 | 0
0 | 41 | 3 | 1 | 3 | 0
0 | 42 | -5 | 138 | -5 | 0
0 | 43 | 2 | 41 | 2 | 0
0 | 44 | -6 | 27 | -6 | 0
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
