Hokkaido-Open-Hardware/PSC-ONE/tool/FST_viewer/validation/v1-gui.png

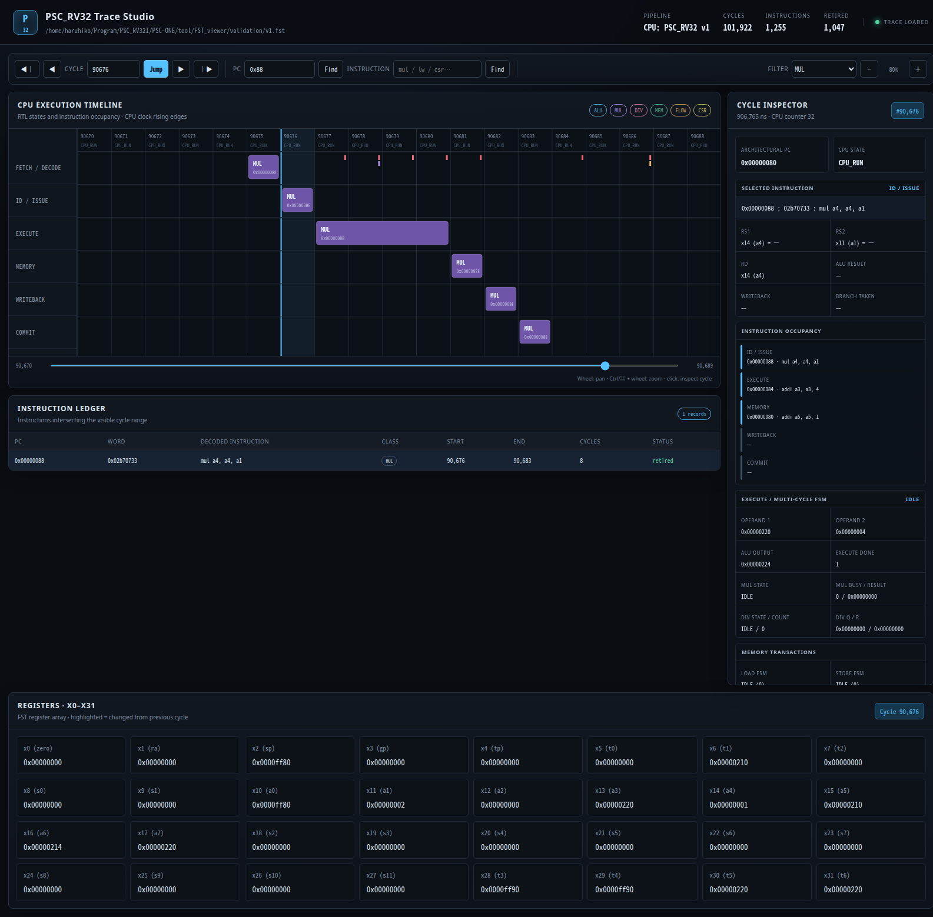
tool/FST_viewer/validation/v1-gui.png
