Hokkaido-Open-Hardware/PSC-ONE/tool/FST_viewer/validation/v2-gui.png

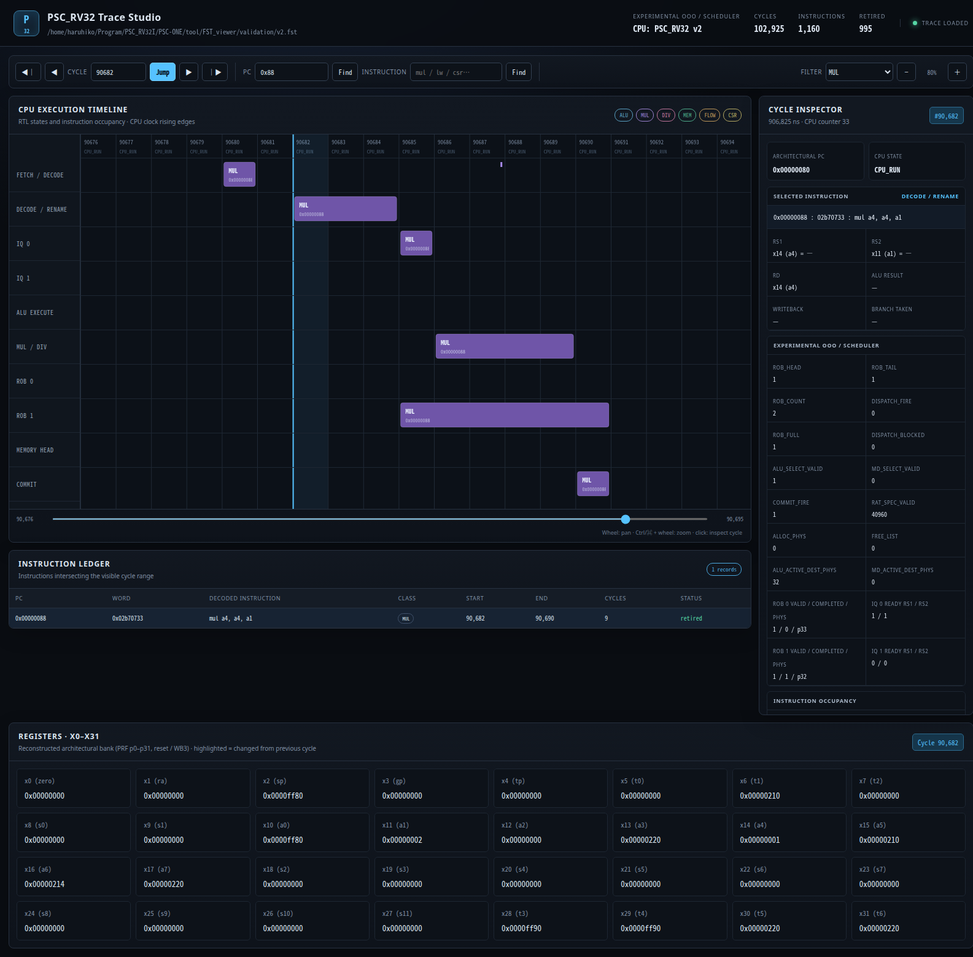
tool/FST_viewer/validation/v2-gui.png
