Hokkaido-Open-Hardware/PSC-ONE/board/PSC-ONE/schematic/PSC-ONE_sch.pdf

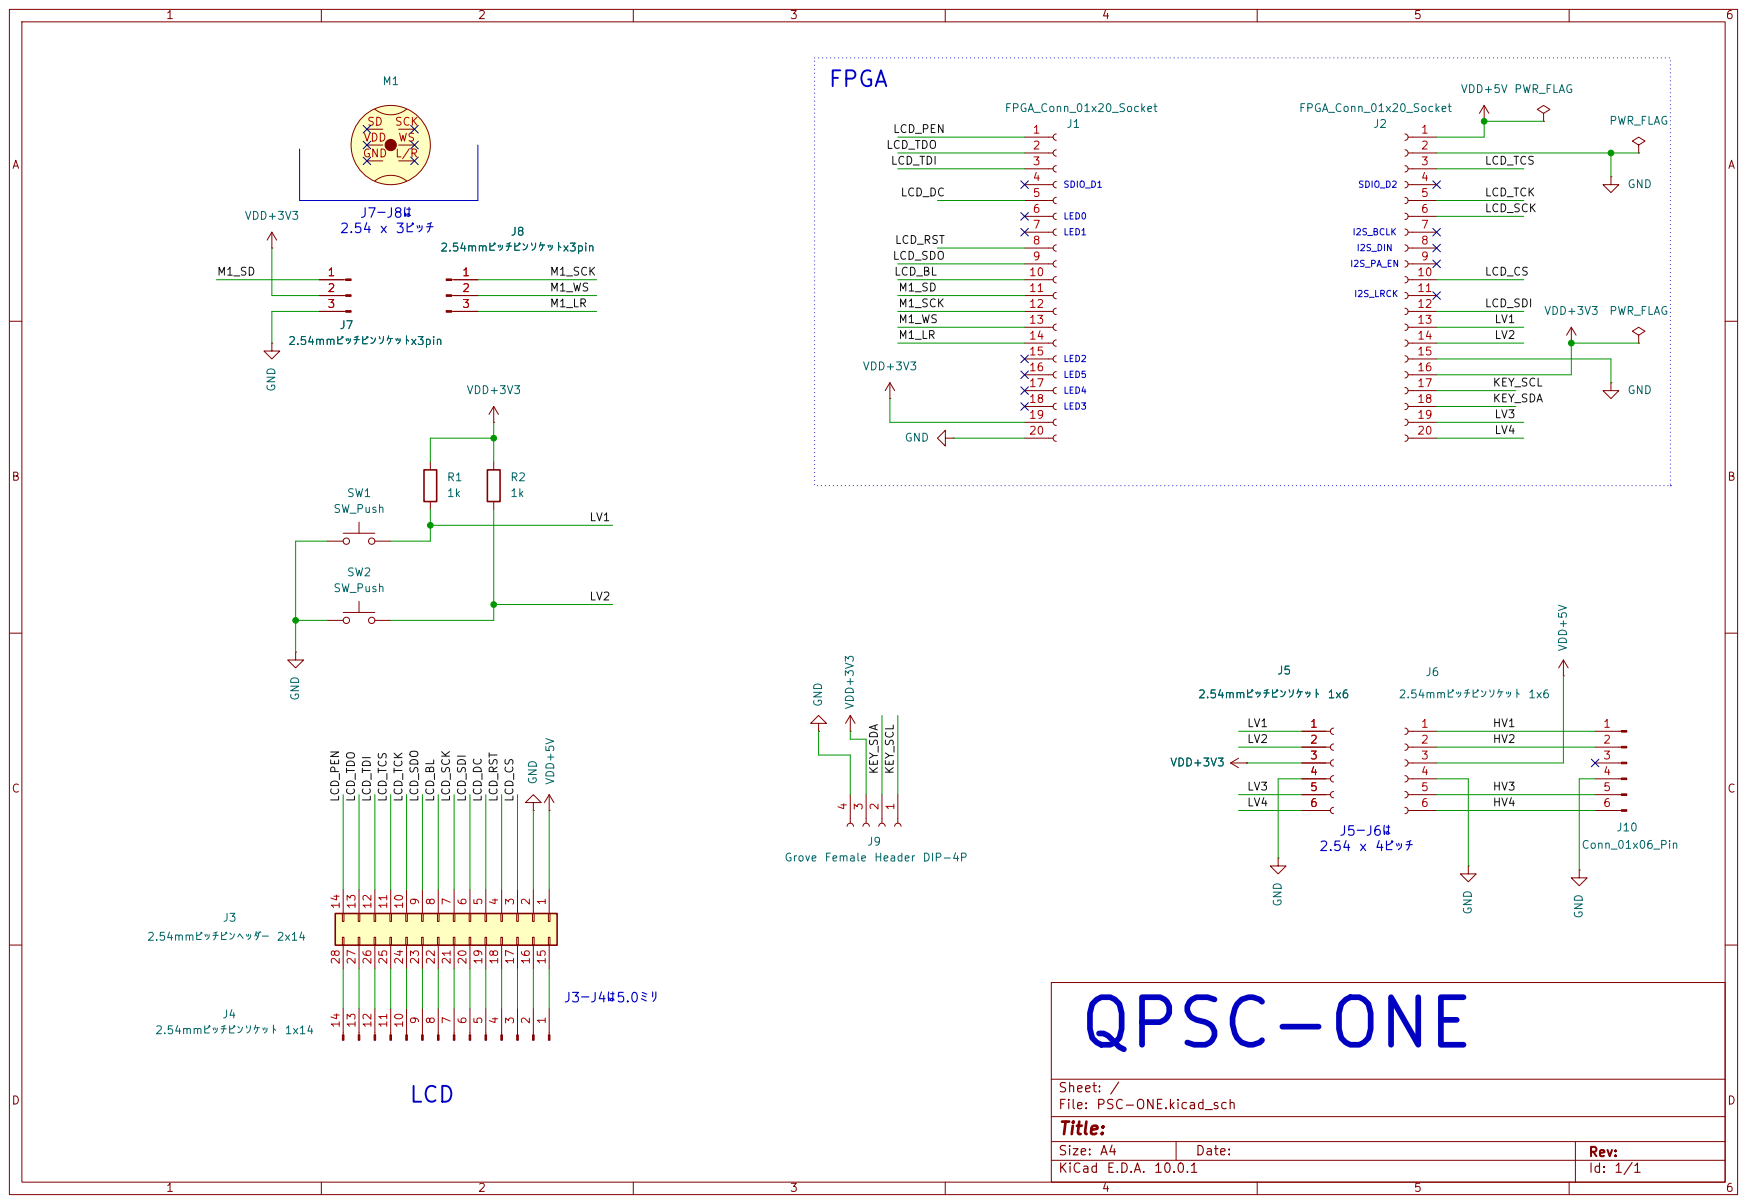
[picture p55: page 1]

J9 Grove Female Header DIP-4P VDD+5V GND L/R

Size: A4 | Rev:
KiCad E.D.A. 10.0.1 | Id: 1/1
