Hokkaido-Open-Hardware/PSC-ONE/board/PSC-ONE/pcb/PSC-ONE.kicad_pcb

## KiCad design board/PSC-ONE/pcb/PSC-ONE.kicad_pcb (2026-09-17)

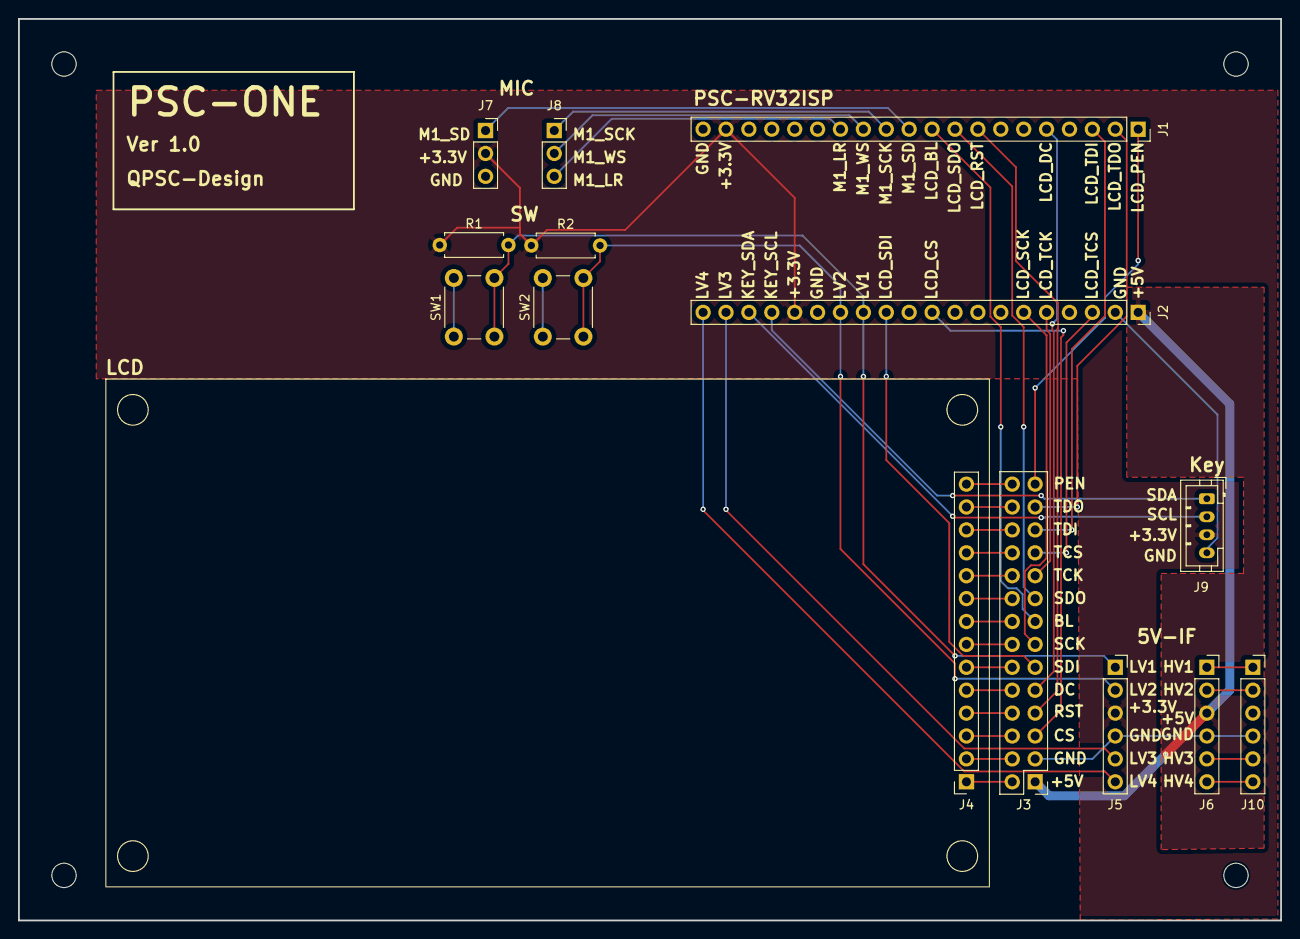
[picture p56: board PSC-ONE.kicad_pcb from above]

Board: 2 copper layers, 140.0 x 100.0 mm, 14 parts (0 on the bottom side), 43 nets.

Parts:
J1, J2: FPGA_Conn_01x20_Socket; PinSocket_1x20_P2.54mm_Vertical
J3: 2.54mmピッチピンヘッダー 2x14; PinHeader_2x14_P2.54mm_Vertical_2
J4: 2.54mmピッチピンソケット 1x14; LCD_PinSocket_1x14_P2.54mm_Vertical
J5, J6: 2.54mmピッチピンソケット 1x6; PinSocket_1x06_P2.54mm_Vertical
J7, J8: 2.54mmピッチピンソケットx3pin; PinSocket_1x03_P2.54mm_Vertical
J9: Grove Female Header DIP-4P; JST_PH_B4B-PH-K_1x04_P2.00mm_Vertical
J10: Conn_01x06_Pin; PinSocket_1x06_P2.54mm_Vertical
R1, R2: 1k; R_Axial_DIN0207_L6.3mm_D2.5mm_P7.62mm_Horizontal
SW1, SW2: SW_Push; SW_PUSH_6mm

Connections:
/HV1: J6.1, J10.1
/HV2: J6.2, J10.2
/HV3: J6.5, J10.5
/HV4: J6.6, J10.6
/KEY_SCL: J2.17, J9.1
/KEY_SDA: J2.18, J9.2
/LCD_BL: J1.10, J3.8
/LCD_CS: J2.10, J3.3
/LCD_DC: J1.5, J3.5
/LCD_PEN: J1.1, J3.14
/LCD_RST: J1.8, J3.4
/LCD_SCK: J2.6, J3.7
/LCD_SDI: J2.12, J3.6
/LCD_SDO: J1.9, J3.9
/LCD_TCK: J2.5, J3.10
/LCD_TCS: J2.3, J3.11
/LCD_TDI: J1.3, J3.12
/LCD_TDO: J1.2, J3.13
/LV1: J2.13, J5.1, R1.2, SW1.2
/LV2: J2.14, J5.2, R2.2, SW2.2
/LV3: J2.19, J5.5
/LV4: J2.20, J5.6
/M1_LR: J1.14, J8.3
/M1_SCK: J1.12, J8.1
/M1_SD: J1.11, J7.1
/M1_WS: J1.13, J8.2
GND: J1.20, J2.2, J2.15, J3.2, J5.4, J6.4, J7.3, J9.4, J10.4, SW1.1, SW2.1
unnamed: J3.15, J4.1
unnamed: J3.16, J4.2
unnamed: J3.17, J4.3
unnamed: J3.18, J4.4
unnamed: J3.19, J4.5
unnamed: J3.20, J4.6
unnamed: J3.21, J4.7
unnamed: J3.22, J4.8
unnamed: J3.23, J4.9
unnamed: J3.24, J4.10
unnamed: J3.25, J4.11
unnamed: J3.26, J4.12
unnamed: J3.27, J4.13
unnamed: J3.28, J4.14
VDD+3V3: J1.19, J2.16, J5.3, J7.2, J9.3, R1.1, R2.1
VDD+5V: J2.1, J3.1, J6.3
