Hokkaido-Open-Hardware/PSC-ONE/software/os/src/kernel/kernel.c

#include "../lib/common.h"
#include "kernel.h"
#include "../api/synap_api.h"
#include "../drivers/sdcard_api.h"
#include "../drivers/timer_api.h"
#include "../drivers/mic_api.h"
#include "../drivers/lcd_api.h"
#include "../drivers/led_api.h"
#include "../api/fft_api.h"
#include "../drivers/mem_test.h"
#include "../api/speech_recognition_api.h"
#include "../api/robot/robot_control.h"

// if 1 : multitask mode
#define MULTITASK_MODE 0 

#define NPU_TESTMODE 1
//#define PSC_LOGOMODE 1

extern uint8_t _binary_shell_bin_start[];
extern uint8_t _binary_shell_bin_end[];
extern char __bss[], __bss_end[], __kernel_stack_top[];
extern char __free_ram[], __free_ram_end[];
extern char __kernel_base[];

struct virtio_virtq *blk_request_vq;
struct virtio_blk_req *blk_req;
paddr_t blk_req_paddr;
uint64_t blk_capacity;

#ifdef USE_SBI_CONSOLE
struct sbiret sbi_call(long arg0, long arg1, long arg2, long arg3,
                       long arg4, long arg5, long fid, long eid) {
    register long a0 __asm__("a0") = arg0;
    register long a1 __asm__("a1") = arg1;
    register long a2 __asm__("a2") = arg2;
    register long a3 __asm__("a3") = arg3;
    register long a4 __asm__("a4") = arg4;
    register long a5 __asm__("a5") = arg5;
    register long a6 __asm__("a6") = fid;
    register long a7 __asm__("a7") = eid;
    __asm__ __volatile__("ecall"
                         : "=r"(a0), "=r"(a1)
                         : "r"(a0), "r"(a1), "r"(a2), "r"(a3), "r"(a4),
                           "r"(a5), "r"(a6), "r"(a7)
                         : "memory");
    return (struct sbiret){.error = a0, .value = a1};
}

void uart_putchar(char ch) {
    sbi_call(ch, 0, 0, 0, 0, 0, 0, 1);
}

long uart_getchar(void) {
    struct sbiret ret = sbi_call(0, 0, 0, 0, 0, 0, 0, 2);
    return ret.error;
}

#else

#ifndef PIO32_ADDR
#define PIO32_ADDR (*(volatile uint32_t *)PSC_BOARD_SWITCH_BASE)
#endif
#ifndef UART_MMIO_BASE
#define UART_MMIO_BASE PSC_BOARD_UART_BASE
#endif
#ifndef UART_TX
#define UART_TX 0x0
#endif
#ifndef UART_RX
#define UART_RX 0x4
#endif
#ifndef UART_ST
#define UART_ST 0x8
#endif
#ifndef ST_TX_BUSY
#define ST_TX_BUSY (1u << 0)
#endif
#ifndef ST_RX_AVAIL
#define ST_RX_AVAIL (1u << 1)
#endif

void putchar(char ch) {
    while (mmio_r32(UART_MMIO_BASE + UART_ST) & ST_TX_BUSY)
        __asm__ __volatile__("nop");
    mmio_w32(UART_MMIO_BASE + UART_TX, (uint32_t)(uint8_t)ch);
}

void uart_putchar(char ch) {
    while (mmio_r32(UART_MMIO_BASE + UART_ST) & ST_TX_BUSY)
        __asm__ __volatile__("nop");
    mmio_w32(UART_MMIO_BASE + UART_TX, (uint32_t)(uint8_t)ch);
}

long uart_getchar_timeout(uint32_t timeout) {
    while (timeout--) {
        if (mmio_r32(UART_MMIO_BASE + UART_ST) & ST_RX_AVAIL)
            return (long)(mmio_r32(UART_MMIO_BASE + UART_RX) & 0xFF);
        __asm__ __volatile__("nop");
    }
    return -1;
}

long uart_getchar(void) {
    while ((mmio_r32(UART_MMIO_BASE + UART_ST) & ST_RX_AVAIL) == 0)
        __asm__ __volatile__("nop");
    return (long)(mmio_r32(UART_MMIO_BASE + UART_RX) & 0xFF);
}

#endif

/* MicroPython owns this SPSC ring while the shell is inside its command.
 * M-mode is the sole producer; S-mode is the sole consumer. Never call into
 * the user VM from M-mode (different address space and exception context).
 */
#include "syscall.h"
#define CONSOLE_RX_SIZE 1024u
static volatile uint8_t console_rx[CONSOLE_RX_SIZE];
static volatile uint32_t console_head, console_tail, console_active;
static volatile uint32_t console_interrupts, console_lost;
static uint32_t console_seen_interrupts, console_saved_ctrl;
static volatile int console_interrupt_char = -1;

void uart_console_irq(void) {
#ifndef USE_SBI_CONSOLE
    if (!console_active) return;
    uint32_t status = mmio_r32(UART_MMIO_BASE + UART_ST);
    if (status & (1u << 3)) {
        console_lost++;
        mmio_w32(UART_MMIO_BASE + 12u, 9u | 4u);
    }
    if (status & ST_RX_AVAIL) {
        uint8_t c = mmio_r32(UART_MMIO_BASE + UART_RX);
        if ((int)c == console_interrupt_char) {
            console_interrupts++;
        } else {
            uint32_t head = console_head;
            if (head - console_tail < CONSOLE_RX_SIZE) {
                console_rx[head & (CONSOLE_RX_SIZE - 1u)] = c;
                console_head = head + 1u;
            } else {
                console_lost++;
            }
        }
    }
#endif
}

long uart_console_control(uint32_t action, int value) {
#ifdef USE_SBI_CONSOLE
    (void)action; (void)value;
    return -1; // PSC UART service requires PSC hardware.
#else
    switch (action) {
    case PSC_CONSOLE_BEGIN:
        if (console_active) return -1;
        console_saved_ctrl = mmio_r32(UART_MMIO_BASE + 12u);
        console_head = console_tail = 0;
        console_interrupts = console_seen_interrupts = console_lost = 0;
        console_interrupt_char = -1;
        enable_machine_timer_trap();
        console_active = 1;
        mmio_w32(UART_MMIO_BASE + 12u, 9u | 6u);
        return 0;
    case PSC_CONSOLE_END:
        mmio_w32(UART_MMIO_BASE + 12u, console_saved_ctrl | 6u);
        console_active = 0;
        return 0;
    case PSC_CONSOLE_READ: {
        uint32_t tail = console_tail;
        if (tail == console_head) return -1;
        uint8_t c = console_rx[tail & (CONSOLE_RX_SIZE - 1u)];
        console_tail = tail + 1u;
        return c;
    }
    case PSC_CONSOLE_SET_INTERRUPT:
        console_interrupt_char = value;
        // Do not carry an execution interrupt past pyexec's NLR boundary
        // into raw framing, source input, or a freshly initialized VM.
        if (value < 0) console_seen_interrupts = console_interrupts;
        return 0;
    case PSC_CONSOLE_POLL_INTERRUPT: {
        uint32_t count = console_interrupts;
        int pending = count != console_seen_interrupts;
        console_seen_interrupts = count;
        return pending;
    }
    case PSC_CONSOLE_AVAILABLE:
        return console_head != console_tail;
    case PSC_CONSOLE_OVERRUN:
        return console_lost;
    default:
        return -1;
    }
#endif
}

/* Publish code copied through PSC's write-back D cache to its separate I cache.
   The maintenance sweep blocks data/MMU admission. A serial load after the
   request waits for that port; fence.i then drops old instruction-cache lines. */
void sync_user_code(void) {
#ifndef USE_SBI_CONSOLE
    __asm__ __volatile__("fence rw, rw\n"
                         "li t0, 2\n"
                         "csrw 0x7f0, t0\n"
                         "csrw 0x7f0, zero\n"
                         "lw zero, 0(%0)\n"
                         :: "r"(__kernel_base) : "t0", "memory");
#endif
    __asm__ __volatile__("fence rw, rw\nfence.i" ::: "memory");
}

paddr_t alloc_pages(uint32_t n) {
    static int initialized;
    static paddr_t next_paddr;
    if (!initialized) {
        next_paddr = (paddr_t)__free_ram;
        initialized = 1;
    }
    paddr_t paddr = next_paddr;
    next_paddr += n * PAGE_SIZE;
    if (next_paddr > (paddr_t)__free_ram_end)
        PANIC("out of memory");
    memset((void *)paddr, 0, n * PAGE_SIZE);
    return paddr;
}

void map_page(uint32_t *table1, uint32_t vaddr, paddr_t paddr, uint32_t flags) {
    if (!is_aligned(vaddr, PAGE_SIZE))
        PANIC("unaligned vaddr %x", vaddr);
    if (!is_aligned(paddr, PAGE_SIZE))
        PANIC("unaligned paddr %x", paddr);
    uint32_t vpn1 = (vaddr >> 22) & 0x3ff;
    if ((table1[vpn1] & PAGE_V) == 0) {
        uint32_t pt_paddr = alloc_pages(1);
        table1[vpn1] = ((pt_paddr / PAGE_SIZE) << 10) | PAGE_V;
    }
    uint32_t vpn0 = (vaddr >> 12) & 0x3ff;
    uint32_t *table0 = (uint32_t *)((table1[vpn1] >> 10) * PAGE_SIZE);
    /* Svade compatibility: no accessed/dirty tracking or A/D fault handler.
       These flags belong only to leaf PTEs; the parent pointer stays V-only. */
    table0[vpn0] = ((paddr / PAGE_SIZE) << 10) | flags | PAGE_V | PAGE_A | PAGE_D;
}

__attribute__((section(".text.boot")))
__attribute__((naked))
void boot(void) {
    __asm__ __volatile__(
        "la sp, __kernel_stack_top\n"
        "li a0, 0\n"
        "j kernel_main\n"
    );
}

__attribute__((naked, used)) void kernel_warm_boot(void) {
    __asm__ __volatile__(
        "la sp, __kernel_stack_top\n"
        "li a0, 1\n"
        "j kernel_main\n"
    );
}

__attribute__((used)) void kernel_main(uint32_t warm) {
#ifndef USE_SBI_CONSOLE
    extern char __data[], __data_end[], __data_initial[];
    size_t data_size = (size_t)__data_end - (size_t)__data;
    if (warm) memcpy(__data, __data_initial, data_size);
    else memcpy(__data_initial, __data, data_size);
#else
    (void)warm;
#endif
    /* Required on warm boot even in simulations that pre-zero RAM. The
       linker aligns __bss to 4 bytes; clear the large buffers a word at a
       time, including any byte tail. Volatile keeps this as word stores. */
    uintptr_t bss = (uintptr_t)__bss, end = (uintptr_t)__bss_end;
    while (end - bss >= sizeof(uint32_t)) {
        *(volatile uint32_t *)bss = 0;
        bss += sizeof(uint32_t);
    }
    while (bss < end) *(volatile uint8_t *)bss++ = 0;
    s_printf("memset = ON\n");
#if NPU_TESTMODE
    s_printf("NPU TEST\n");
    s_call_sa_api(4, true, true);
#endif
#if PSC_LOGOMODE
    s_printf("Draw PSC Logo\n");
    lcd_draw_boot_logo();
#else
    // tft_init
    s_printf("tft init\n");
    tft_init_seq(AFTER_WAIT);
#endif
    s_printf("PSC_OS Boot Start.........\n");
    s_printf("--- memset done ---\n");
    s_printf("Test Ver: test_1.8.0\n");
    s_printf(
        "\n"
        "  PSC-ONE / PSC-OS\n"
        "  RISC-V Operating System\n"
        "  --------------------------------------------------\n"
        "  Build     %s %s\n"
        "  CPU       PSC_RV32 / Sv32 MMU\n"
        "  Console   SBI or MMIO UART\n"
        "\n"
        "  SYSTEM    hello, primes, dump\n"
        "  COMPUTE   sa_start, speech\n"
        "  ROBOT     robot_control\n"
        "  STORAGE   sd_read, sd_write\n"
        "  AUDIO     mic_read, mic_write\n"
        "  FILES     fat32_info, fat32_ls, fat32_cat,\n"
        "            fat32_touch\n"
        "  RUNTIME   microPython, run (.ELF)\n"
        "\n"
        "  MicroPython reset: Ctrl+D\n"
        "  Return to shell  : import psc; psc.exit()\n"
        "  QEMU exit        : Ctrl+A, C -> q\n"
        "  --------------------------------------------------\n"
        "\n",
        __DATE__, __TIME__);

    WRITE_CSR(stvec, (uint32_t)kernel_entry);

#ifdef PSC_ROBOT_SIM
    /* Dedicated integration image; normal OS startup is unchanged. */
    robot_control_run();
#endif
#ifdef PSC_OS_DUMMY_TEST
    run_multitask_dummy_test();
    PANIC("dummy scheduler test returned");
#endif

    s_printf("--- create_process_1 ---\n");
    idle_proc = create_process(NULL, 0);
    idle_proc->pid = 0;
    current_proc = idle_proc;

    /* 
    task1: 本物shell 
    */
    s_printf("--- create_process_2 ---\n");
#if !KERNEL_USER_FROM_SD
    size_t shell_size = _binary_shell_bin_end - _binary_shell_bin_start;
    create_process(_binary_shell_bin_start, shell_size);
#else
    extern char __shell_image_size[];
    create_process_from_sd((size_t)__shell_image_size);
#endif
    __asm__ __volatile__("fence.i" ::: "memory");

// if 1 : multitask mode
#if MULTITASK_MODE
    /* 
    task2: kernel内テストtask 
    */
    s_printf("--- create_process_3 ---\n");
    create_kernel_task(shell_idle_task);

    //ここのコメントアウトを外すとブートしない
    preemption_start();
    
    /*
     * yield()しない。
     * Timer IRQだけで idle -> shell -> shell_idle_task
     * と切り替わることを確認する。
     */
    for (;;) {
        __asm__ __volatile__("nop");
    }
#else
    s_printf("--- yield ---\n");
    yield();
    s_printf("--- yield end ---\n");
    PANIC("switched to idle process");
#endif
}
