Hokkaido-Open-Hardware/PSC-ONE/hardware/rtl/soc/cpu_rv64/src/PSC_InstructionUnit.sv

`timescale 1ns/1ps
// NISHIHARU

import PSC_Types::*;

// Coordinate pipeline stages, hazards, memory, commit and traps.
module PSC_InstructionUnit (
    input  logic        clock,
    input  logic        reset_n,
    input  logic        cpu_stop,
    input  logic        cpu_trap,
    input  logic        timer_irq_ext,
    output logic        branch_resolve_valid,
    output logic        branch_resolve_taken,
    output logic [63:0] branch_resolve_pc,
    output logic [63:0] branch_resolve_target,
    input  logic [1:0]  priv_mode,

    // PC / current FIFO head
    output logic [63:0] pc,
    output logic [63:0] counter,
    input  logic [31:0] opcode,
    input  logic [63:0] pc_now,

    // FIFO / decode handshake
    input  logic        fifo_req_ready,
    input  logic        fifo_read_ready,
    output logic        fifo_read_valid,
    output logic        fifo_flush,
    input  dec_ctrl_t   decoded_ctrl,
    output logic        decode_enb,
    input  logic        decode_done,

    // Execute handshake
    output logic        execute_valid,
    output dec_ctrl_t   execute_ctrl,
    output logic [63:0] execute_reg_data_1,
    output logic [63:0] execute_reg_data_2,
    input  logic [63:0] execute_alu_data,
    input  logic        execute_done,

    // Memory-stage request and response
    output dec_ctrl_t   memory_ctrl,
    output logic [63:0] memory_alu_data,
    output logic [63:0] memory_reg_data_1,
    output logic [63:0] memory_reg_data_2,
    output logic [63:0] memory_pc,
    output logic        load_valid,
    output logic        store_valid,
    input  logic        load_done,
    input  logic        store_done,
    input  logic [63:0] load_read_data,
    input  logic        load_unaligned,

    // Commit / CSR interface
    input  csr_state_t  csr_state,
    input  logic [63:0] csr_rdata,
    output logic [11:0] csr_read_addr,
    output logic [63:0] csr_old_value,
    output logic [63:0] csr_reg_data_1,
    output logic        csr_enb,
    output logic        csr_valid,
    output dec_ctrl_t   commit_ctrl,
    output logic [63:0] commit_alu_data,
    output logic        commit_branch_taken,
    output logic        timer_irq_take,

    // Fault information
    input  logic        d_pf,
    input  logic        i_pf,
    input  logic        d_pf_event,
    input  logic        i_pf_event,
    input  logic [4:0]  trap_scause,

    output logic        execute_task_busy,
    output logic        execute_task_done
);

    // ID/ISSUE holds decoded control and PC.
    typedef struct packed {
        logic valid;
        dec_ctrl_t   ctrl;
        logic [63:0] pc;
    } id_issue_t;

    // ISSUE/EX captures operands after hazard checking.
    typedef struct packed {
        logic valid;
        dec_ctrl_t   ctrl;
        logic [63:0] pc;
        logic [63:0] reg_data_1;
        logic [63:0] reg_data_2;
    } issue_ex_t;

    // EX/MEM holds the ALU/address result, store data and memory control.
    typedef struct packed {
        logic valid;
        dec_ctrl_t   ctrl;
        logic [63:0] pc;
        logic [63:0] reg_data_1;
        logic [63:0] reg_data_2;
        logic [63:0] alu_data;
    } ex_mem_t;

    // MEM/WB and commit carry the final register write value.
    typedef struct packed {
        logic valid;
        dec_ctrl_t   ctrl;
        logic [63:0] pc;
        logic [63:0] reg_data_1;
        logic [63:0] alu_data;
        logic branch_taken;
        logic [63:0] w_data;
    } wb_t;

    id_issue_t id_issue;
    issue_ex_t issue_ex;
    ex_mem_t   ex_mem;
    wb_t       mem_wb;
    wb_t       commit;

    logic [63:0] regfile_rdata_1;
    logic [63:0] regfile_rdata_2;
    logic regfile_wen;
    logic [63:0] regfile_wdata;

    logic decode_fire;
    logic issue_fire;
    logic ex_fire;
    logic mem_fire;
    logic id_issue_ready;
    logic issue_ex_ready;
    logic ex_mem_ready;
    logic mem_wb_ready;
    logic memory_complete;
    logic [1:0] csr_read_ready;
    logic branch_taken_now;
    logic raw_hazard;
    logic raw_hazard_rs1;
    logic raw_hazard_rs2;
    logic [63:0] issue_reg_data_1;
    logic [63:0] issue_reg_data_2;
    logic [2:0] forward_sel_rs1;
    logic [2:0] forward_sel_rs2;
    logic mem_wb_forwardable;
    logic backend_serial;
    logic backend_empty;
    logic pipeline_empty;
    logic issue_serial;
    logic issue_forwarding_consumer;
    logic early_branch_valid;
    logic commit_branch_redirected;
    logic pc_update_valid;
    dec_ctrl_t   pc_update_ctrl;
    logic [63:0] pc_update_alu_data;
    logic pc_update_branch_taken;
    logic timer_irq_request;
    logic regfile_read_ready;

    // ID addresses reach the synchronous BSRAM on the edge after decode.
    // A newly replaced ID record must not consume the previous read data.
    always_ff @(posedge clock or negedge reset_n) begin
        if (!reset_n)
            regfile_read_ready <= 1'b0;
        else if (cpu_stop || fifo_flush || decode_fire || issue_fire)
            regfile_read_ready <= 1'b0;
        else
            regfile_read_ready <= id_issue.valid;
    end

    // Serialize instructions that affect control flow, privilege or ordering.
    function automatic logic serializing_instruction(input dec_ctrl_t ctrl);
        serializing_instruction =
            ((ctrl.is_load || ctrl.is_store) && !ctrl.pipeline_type) ||
            (ctrl.pc_sel != 2'b00)           ||
            ctrl.csr_wr                     ||
            ctrl.is_fence                   ||
            ctrl.is_fence_i                 ||
            ctrl.is_sfence_vma              ||
            ctrl.is_ecall                   ||
            ctrl.is_ebreak                  ||
            ctrl.is_mret                    ||
            ctrl.is_sret                    ||
            ctrl.raise_illegal_instruction;
    endfunction

    // Ordinary branches/jumps may redirect before architectural commit.
    function automatic logic early_redirect_instruction(input dec_ctrl_t ctrl);
        early_redirect_instruction =
            (ctrl.pc_sel != 2'b00)             &&
            !ctrl.is_ecall                     &&
            !ctrl.is_mret                      &&
            !ctrl.is_sret                      &&
            !ctrl.raise_illegal_instruction;
    endfunction

    // Evaluate branch/jump direction using the decoded PC-select mode and funct3.
    function automatic logic branch_exec(
        input  logic [1:0] pc_sel,
        input  logic [2:0] funct3,
        input  logic [63:0] data1,
        input  logic [63:0] data2
    );
        begin
            case (pc_sel)
                2'b01: begin
                    case (funct3)
                        3'b000: branch_exec = (data1 == data2);
                        3'b001: branch_exec = (data1 != data2);
                        3'b100: branch_exec = ($signed(data1) < $signed(data2));
                        3'b101: branch_exec = ($signed(data1) >= $signed(data2));
                        3'b110: branch_exec = (data1 < data2);
                        3'b111: branch_exec = (data1 >= data2);
                        default: branch_exec = 1'b0;
                    endcase
                end
                2'b10: branch_exec = 1'b1;
                default: branch_exec = 1'b0;
            endcase
        end
    endfunction

    // Memory returns the aligned 64-bit beat; the low address selects a lane.
    function automatic logic [63:0] load_result(
        input logic [63:0] raw_data,
        input logic [2:0] low3,
        input logic [2:0] funct3
    );
        logic [63:0] shifted;
        begin
            shifted = raw_data >> {low3, 3'b0};
            case (funct3)
                3'b000: load_result = {{56{shifted[7]}}, shifted[7:0]};
                3'b001: load_result = {{48{shifted[15]}}, shifted[15:0]};
                3'b010: load_result = {{32{shifted[31]}}, shifted[31:0]};
                3'b011: load_result = shifted;
                3'b100: load_result = {56'b0, shifted[7:0]};
                3'b101: load_result = {48'b0, shifted[15:0]};
                3'b110: load_result = {32'b0, shifted[31:0]};
                default: load_result = '0;
            endcase
        end
    endfunction

    // Register file and hazard interlock.
    assign regfile_wen               = commit.valid && commit.ctrl.rf_wen &&
                         (commit.ctrl.w_addr != 5'd0);
    assign regfile_wdata             = commit.w_data;

    // Architectural integer register file. Writes occur only from commit.
    PSC_Register u_regfile (
        .clock             (clock),
        .reset_n           (reset_n),
        .register_wenb     (regfile_wen),
        .rf_wen            (regfile_wen),
        .w_addr            (commit.ctrl.w_addr),
        .w_data            (regfile_wdata),
        .r_addr1           (id_issue.ctrl.r_addr1),
        .r_addr2           (id_issue.ctrl.r_addr2),
        .reg_data_1        (regfile_rdata_1),
        .reg_data_2        (regfile_rdata_2)
    );

    // The youngest matching producer wins; stall until its value is available.
    always_comb begin
        mem_wb_forwardable = (mem_wb.ctrl.wb_sel != 2'b11);

        issue_reg_data_1 = regfile_rdata_1;
        raw_hazard_rs1   = 1'b0;
        forward_sel_rs1  = 3'd0;
        if (id_issue.ctrl.use_rs1 && (id_issue.ctrl.r_addr1 != 5'd0)) begin
            if (issue_ex.valid && issue_ex.ctrl.rf_wen &&
                (issue_ex.ctrl.w_addr != 5'd0) &&
                (id_issue.ctrl.r_addr1 == issue_ex.ctrl.w_addr)) begin
                // Wait for MEM/WB to keep the EX ALU off the operand-selection path.
                raw_hazard_rs1   = 1'b1;
                forward_sel_rs1  = 3'd1;
            end else if (ex_mem.valid && ex_mem.ctrl.rf_wen &&
                         (ex_mem.ctrl.w_addr != 5'd0) &&
                         (id_issue.ctrl.r_addr1 == ex_mem.ctrl.w_addr)) begin
                // Wait for MEM/WB to keep load formatting off the operand-selection path.
                raw_hazard_rs1   = 1'b1;
                forward_sel_rs1  = 3'd2;
            end else if (mem_wb.valid && mem_wb.ctrl.rf_wen &&
                         (mem_wb.ctrl.w_addr != 5'd0) &&
                         (id_issue.ctrl.r_addr1 == mem_wb.ctrl.w_addr)) begin
                issue_reg_data_1 = mem_wb.w_data;
                raw_hazard_rs1   = !mem_wb_forwardable;
                forward_sel_rs1  = 3'd3;
            end else if (commit.valid && commit.ctrl.rf_wen &&
                         (commit.ctrl.w_addr != 5'd0) &&
                         (id_issue.ctrl.r_addr1 == commit.ctrl.w_addr)) begin
                // Wait one cycle for the commit write to reach the register file.
                raw_hazard_rs1   = 1'b1;
                forward_sel_rs1  = 3'd4;
            end
        end

        issue_reg_data_2 = regfile_rdata_2;
        raw_hazard_rs2   = 1'b0;
        forward_sel_rs2  = 3'd0;
        if (id_issue.ctrl.use_rs2 && (id_issue.ctrl.r_addr2 != 5'd0)) begin
            if (issue_ex.valid && issue_ex.ctrl.rf_wen &&
                (issue_ex.ctrl.w_addr != 5'd0) &&
                (id_issue.ctrl.r_addr2 == issue_ex.ctrl.w_addr)) begin
                raw_hazard_rs2   = 1'b1;
                forward_sel_rs2  = 3'd1;
            end else if (ex_mem.valid && ex_mem.ctrl.rf_wen &&
                         (ex_mem.ctrl.w_addr != 5'd0) &&
                         (id_issue.ctrl.r_addr2 == ex_mem.ctrl.w_addr)) begin
                raw_hazard_rs2   = 1'b1;
                forward_sel_rs2  = 3'd2;
            end else if (mem_wb.valid && mem_wb.ctrl.rf_wen &&
                         (mem_wb.ctrl.w_addr != 5'd0) &&
                         (id_issue.ctrl.r_addr2 == mem_wb.ctrl.w_addr)) begin
                issue_reg_data_2 = mem_wb.w_data;
                raw_hazard_rs2   = !mem_wb_forwardable;
                forward_sel_rs2  = 3'd3;
            end else if (commit.valid && commit.ctrl.rf_wen &&
                         (commit.ctrl.w_addr != 5'd0) &&
                         (id_issue.ctrl.r_addr2 == commit.ctrl.w_addr)) begin
                raw_hazard_rs2   = 1'b1;
                forward_sel_rs2  = 3'd4;
            end
        end

        raw_hazard = raw_hazard_rs1 || raw_hazard_rs2;
    end

    // Csr's registered decode and partial read mux need two complete MEM
    // cycles. Keep EX/MEM (including the address) stable until both elapse.
    // A replacement, cancellation or retirement always starts a fresh read.
    always_ff @(posedge clock or negedge reset_n) begin
        if (!reset_n)
            csr_read_ready <= 2'b00;
        else if (cpu_stop || d_pf || ex_fire || mem_fire)
            csr_read_ready <= 2'b00;
        else if (ex_mem.valid && (ex_mem.ctrl.wb_sel == 2'b11))
            csr_read_ready <= {csr_read_ready[0], 1'b1};
        else
            csr_read_ready <= 2'b00;
    end

    // Stage handshakes hold EX/MEM and backpressure issue until memory completes.
    assign memory_complete           = ex_mem.ctrl.is_load  ? load_done  :
                             ex_mem.ctrl.is_store ? store_done :
                             (ex_mem.ctrl.wb_sel == 2'b11) ? csr_read_ready[1] : 1'b1;

    assign mem_wb_ready              = 1'b1;
    assign mem_fire                  = ex_mem.valid && memory_complete && mem_wb_ready;
    assign ex_mem_ready              = !ex_mem.valid || mem_fire;
    assign execute_valid             = issue_ex.valid && ex_mem_ready;
    assign ex_fire                   = issue_ex.valid && execute_done && ex_mem_ready;
    assign issue_ex_ready            = !issue_ex.valid || ex_fire;

    assign backend_empty             = !issue_ex.valid && !ex_mem.valid &&
                            !mem_wb.valid && !commit.valid;
    assign pipeline_empty            = !id_issue.valid && backend_empty;
    assign backend_serial            =
                            (issue_ex.valid && serializing_instruction(issue_ex.ctrl)) ||
                            (ex_mem.valid   && serializing_instruction(ex_mem.ctrl))   ||
                            (mem_wb.valid   && serializing_instruction(mem_wb.ctrl))   ||
                            (commit.valid   && serializing_instruction(commit.ctrl));
    assign issue_serial              = serializing_instruction(id_issue.ctrl);
    // Stores and control transfers may consume forwarded older ALU results.
    assign issue_forwarding_consumer = id_issue.ctrl.is_store ||
                                       (id_issue.ctrl.pc_sel != 2'b00);

    assign id_issue_ready            = !id_issue.valid || issue_fire;
    // Drain admitted instructions before taking a precise timer interrupt.
    assign timer_irq_request         = timer_irq_ext && csr_state.mstatus[3] &&
                               csr_state.mie[7];
    assign timer_irq_take            = timer_irq_request && pipeline_empty;

    assign decode_enb                = fifo_req_ready && id_issue_ready &&
                        !cpu_stop && !cpu_trap && !timer_irq_request;
    assign decode_fire               = decode_done && fifo_req_ready && id_issue_ready &&
                         !timer_irq_request;
    assign issue_fire                = id_issue.valid && regfile_read_ready && issue_ex_ready &&
                            !raw_hazard && !backend_serial &&
                            (!issue_serial || backend_empty ||
                            issue_forwarding_consumer);
    assign fifo_read_valid           = decode_fire;

    assign execute_ctrl              = issue_ex.valid ? issue_ex.ctrl : '0;
    assign execute_reg_data_1        = issue_ex.reg_data_1;
    assign execute_reg_data_2        = issue_ex.reg_data_2;

    assign memory_ctrl               = ex_mem.valid ? ex_mem.ctrl : '0;
    assign memory_alu_data           = ex_mem.alu_data;
    assign memory_reg_data_1         = ex_mem.reg_data_1;
    assign memory_reg_data_2         = ex_mem.reg_data_2;
    assign memory_pc                 = ex_mem.pc;
    assign load_valid                = ex_mem.valid && ex_mem.ctrl.is_load;
    assign store_valid               = ex_mem.valid && ex_mem.ctrl.is_store;

    // Resolve the branch condition using operands carried into the memory stage.
    assign branch_taken_now          = branch_exec(
        ex_mem.ctrl.pc_sel,
        ex_mem.ctrl.funct3,
        ex_mem.reg_data_1,
        ex_mem.reg_data_2
    );

    assign commit_ctrl               = commit.valid ? commit.ctrl : '0;
    assign commit_alu_data           = commit.alu_data;
    assign commit_branch_taken       = commit.valid && commit.branch_taken;
    assign csr_read_addr             = ex_mem.ctrl.csr_addr;
    assign csr_old_value             = commit.w_data;
    assign csr_reg_data_1            = commit.reg_data_1;
    assign csr_enb                   = commit.valid;

    // Branches already redirected from MEM/WB must not redirect again at commit.
    assign commit_branch_redirected  =
        commit.valid && commit.branch_taken &&
        early_redirect_instruction(commit.ctrl);
    assign execute_task_busy         = id_issue.valid || issue_ex.valid ||
                               ex_mem.valid || mem_wb.valid ||
                               (commit.valid && !commit_branch_redirected);
    assign execute_task_done         = commit.valid;

    // Redirect from MEM/WB; retain architectural write-back and CSR effects at commit.
    assign early_branch_valid        =
        mem_wb.valid && mem_wb.branch_taken &&
        early_redirect_instruction(mem_wb.ctrl);
    assign pc_update_valid           = early_branch_valid ||
                             (commit.valid && !commit_branch_redirected);
    assign pc_update_ctrl            = early_branch_valid ? mem_wb.ctrl : commit_ctrl;
    assign pc_update_alu_data        = early_branch_valid
                              ? mem_wb.alu_data : commit_alu_data;
    assign pc_update_branch_taken    = early_branch_valid ||
                                    (commit.valid && commit.branch_taken &&
                                     !commit_branch_redirected);

    // Discard prefetched/decoded instructions on redirects and traps.
    assign fifo_flush                = d_pf || i_pf || timer_irq_take ||
                        early_branch_valid ||
                        (commit.valid &&
                        (commit.ctrl.is_fence_i              ||
                         commit.ctrl.is_sfence_vma           ||
                         commit.ctrl.is_ecall                ||
                         commit.ctrl.is_ebreak               ||
                         commit.ctrl.is_mret                 ||
                         commit.ctrl.is_sret                 ||
                         commit.ctrl.raise_illegal_instruction ||
                         cpu_trap));

    // MEM/WB already registers the actual MEM-stage branch result. Never
    // classify a simultaneous exception/privilege redirect as a prediction hit.
    assign branch_resolve_valid = mem_wb.valid &&
        early_redirect_instruction(mem_wb.ctrl) &&
        !d_pf && !i_pf && !timer_irq_take && !cpu_trap &&
        !(commit.valid && (commit.ctrl.is_fence_i || commit.ctrl.is_sfence_vma ||
          commit.ctrl.is_ecall || commit.ctrl.is_ebreak || commit.ctrl.is_mret || commit.ctrl.is_sret ||
          commit.ctrl.raise_illegal_instruction));
    assign branch_resolve_taken  = mem_wb.branch_taken;
    assign branch_resolve_pc     = mem_wb.pc;
    assign branch_resolve_target = {mem_wb.alu_data[63:1], 1'b0};

    // Publish the CSR snapshot one edge after the commit write.
    always_ff @(posedge clock or negedge reset_n) begin
        if (!reset_n)
            csr_valid <= 1'b0;
        else
            csr_valid <= commit.valid;
    end

    // Flush/stop cancels only the valid bit. Payload capture depends on the
    // stage transfer alone; invalid payload never causes an architectural effect.
    // This removes the global clear signal from the wide payload enables.
    // ID/ISSUE accepts decoded instructions and discards them on flush.
    always_ff @(posedge clock or negedge reset_n) begin
        if (!reset_n) begin
            id_issue  <= '0;
        end else begin
            if (cpu_stop || fifo_flush)
                id_issue.valid <= 1'b0;
            else if (decode_fire)
                id_issue.valid <= 1'b1;
            else if (issue_fire)
                id_issue.valid <= 1'b0;

            if (decode_fire) begin
                id_issue.ctrl       <= decoded_ctrl;
                id_issue.pc         <= pc_now;
            end
        end
    end

    // ISSUE/EX captures operands only on successful issue.
    always_ff @(posedge clock or negedge reset_n) begin
        if (!reset_n) begin
            issue_ex  <= '0;
        end else begin
            if (cpu_stop || d_pf)
                issue_ex.valid <= 1'b0;
            else if (issue_fire)
                issue_ex.valid <= 1'b1;
            else if (ex_fire)
                issue_ex.valid <= 1'b0;

            if (issue_fire) begin
                issue_ex.ctrl       <= id_issue.ctrl;
                issue_ex.pc         <= id_issue.pc;
                issue_ex.reg_data_1 <= issue_reg_data_1;
                issue_ex.reg_data_2 <= issue_reg_data_2;
            end
        end
    end

    // EX/MEM captures completed EX results and holds them during memory waits.
    always_ff @(posedge clock or negedge reset_n) begin
        if (!reset_n) begin
            ex_mem    <= '0;
        end else begin
            if (cpu_stop || d_pf)
                ex_mem.valid <= 1'b0;
            else if (ex_fire)
                ex_mem.valid <= 1'b1;
            else if (mem_fire)
                ex_mem.valid <= 1'b0;

            if (ex_fire) begin
                ex_mem.ctrl         <= issue_ex.ctrl;
                ex_mem.pc           <= issue_ex.pc;
                ex_mem.reg_data_1   <= issue_ex.reg_data_1;
                ex_mem.reg_data_2   <= issue_ex.reg_data_2;
                ex_mem.alu_data     <= execute_alu_data;
            end
        end
    end

    // MEM/WB selects ALU, formatted load, PC+4 or CSR write-back data.
    always_ff @(posedge clock or negedge reset_n) begin
        if (!reset_n) begin
            mem_wb    <= '0;
        end else begin
            if (cpu_stop || d_pf)
                mem_wb.valid <= 1'b0;
            else if (mem_fire)
                mem_wb.valid <= 1'b1;
            else
                mem_wb.valid <= 1'b0;

            if (mem_fire) begin
                mem_wb.ctrl         <= ex_mem.ctrl;
                mem_wb.pc           <= ex_mem.pc;
                mem_wb.reg_data_1   <= ex_mem.reg_data_1;
                mem_wb.alu_data     <= ex_mem.alu_data;
                mem_wb.branch_taken <= branch_taken_now;
                case (ex_mem.ctrl.wb_sel)
                    2'b00: mem_wb.w_data <= ex_mem.alu_data;
                    2'b01: mem_wb.w_data <= load_result(
                                                load_read_data,
                                                load_unaligned ? 3'b0 : ex_mem.alu_data[2:0],
                                                ex_mem.ctrl.funct3);
                    2'b10: mem_wb.w_data <= ex_mem.pc + 64'd4;
                    default: mem_wb.w_data <= csr_rdata;
                endcase
            end
        end
    end

    // Commit retires MEM/WB instructions in order.
    always_ff @(posedge clock or negedge reset_n) begin
        if (!reset_n) begin
            commit    <= '0;
        end else begin
            if (cpu_stop || d_pf)
                commit.valid <= 1'b0;
            else if (mem_wb.valid)
                commit.valid <= 1'b1;
            else
                commit.valid <= 1'b0;

            if (mem_wb.valid) begin
                commit.ctrl         <= mem_wb.ctrl;
                commit.pc           <= mem_wb.pc;
                commit.reg_data_1   <= mem_wb.reg_data_1;
                commit.alu_data     <= mem_wb.alu_data;
                commit.branch_taken <= mem_wb.branch_taken;
                commit.w_data       <= mem_wb.w_data;
            end
        end
    end

    // Architectural PC advances at commit or redirects on branches/traps.
    PSC_PC u_PSC_PC (
        .clock             (clock),
        .reset_n           (reset_n),
        .cpu_stop          (cpu_stop),
        .execute_task_done (pc_update_valid),
        .alu_data          (pc_update_alu_data),
        .pc_sel2           (pc_update_branch_taken),
        .decoder_ctrl      (pc_update_ctrl),
        .cpu_trap          (cpu_trap),
        .priv_mode         (priv_mode),
        .d_pf              (d_pf_event),
        .i_pf              (i_pf_event),
        .trap_scause       (trap_scause),
        .timer_irq_take    (timer_irq_take),
        .csr_state         (csr_state),
        .pc                (pc),
        .counter           (counter)
    );

// Optional simulation-only pipeline trace for forwarding and RAW stalls.
`ifdef PIPELINE_TRACE
    always_ff @(posedge clock) begin
        if (reset_n && issue_fire &&
            ((forward_sel_rs1 != 3'd0) || (forward_sel_rs2 != 3'd0))) begin
            $display("FWD clock=%0t pc=%08x rs1=x%0d src=%0d data=%08x rs2=x%0d src=%0d data=%08x",
                     $time, id_issue.pc,
                     id_issue.ctrl.r_addr1, forward_sel_rs1, issue_reg_data_1,
                     id_issue.ctrl.r_addr2, forward_sel_rs2, issue_reg_data_2);
        end
        if (reset_n && id_issue.valid && raw_hazard) begin
            $display("RAW-STALL clock=%0t pc=%08x rs1=x%0d stall=%0b rs2=x%0d stall=%0b",
                     $time, id_issue.pc,
                     id_issue.ctrl.r_addr1, raw_hazard_rs1,
                     id_issue.ctrl.r_addr2, raw_hazard_rs2);
        end
        if (reset_n && (id_issue.valid || issue_ex.valid || ex_mem.valid ||
                        mem_wb.valid || commit.valid)) begin
            $display("PIPE clock=%0t ID=%0b:%08x ISSUE=%0b:%08x EX=%0b:%08x MEM=%0b:%08x WB=%0b:%08x COMMIT=%0b:%08x",
                     $time,
                     id_issue.valid, id_issue.pc,
                     issue_fire, id_issue.pc,
                     issue_ex.valid, issue_ex.pc,
                     ex_mem.valid, ex_mem.pc,
                     mem_wb.valid, mem_wb.pc,
                     commit.valid, commit.pc);
        end
    end
`endif

endmodule
