Hokkaido-Open-Hardware/PSC-ONE/hardware/rtl/soc/cpu_rv64/src/Csr.sv

`timescale 1ns / 1ps
module Csr #(
    // Peripheral observation ports expose the low bits of 64-bit CSRs.
    // Architectural CSR state/readback and status inputs remain XLEN=64.
    parameter integer PERIPHERAL_CSR_WIDTH = 32,
    parameter integer PIPELINED_READ = 0
) (
    input  logic        clock,
    input  logic        reset_n,
    input  logic        csr_enb,
    input  logic        csr_valid,

    // ==== from pipeline (CSR ops) ====
    input  logic        csr_wr,              // CSRRW/CSRRS/CSRRC (*I含む)
    input  logic [1:0]  csr_cmd,             // 0:RW, 1:RS(OR), 2:RC(ANDN)
    input  logic        csr_use_imm,         // *I (zimm)
    input  logic [11:0] csr_addr,            // CSR address
    input  logic [11:0] csr_read_addr,       // pipelined read address
    input  logic [63:0] csr_old_value,       // old value captured before commit
    input  logic [63:0] csr_rs1_val,         // rs1 value
    input  logic [4:0]  csr_zimm,            // zimm (0..31)
    output logic [63:0] csr_rdata,           // old value to rd

    // ==== Supervisor trap in/out ====
    input  logic        set_trap,
    input  logic [63:0] trap_sepc,
    input  logic [63:0] trap_scause,
    input  logic [63:0] trap_stval,
    input  logic        do_sret,

    // ==== Machine trap in/out ====
    input  logic        set_mtrap,           // TBD
    input  logic [63:0] trap_mepc,
    input  logic [63:0] trap_mcause,
    input  logic        do_mret,

    // ==== mip (pending) ====
    input  logic        set_msip,
    input  logic        clr_msip,
    input  logic        set_mtip,
    input  logic        clr_mtip,
    input  logic        set_meip,
    input  logic        clr_meip,

    // ==== current privilege mode ====
    output logic [1:0]  priv_mode,

    // ==== observes (not used by the CPP test, but kept) ====
    output logic [63:0] out_mstatus,
    output logic [63:0] out_medeleg,
    output logic [63:0] out_mie,
    output logic [63:0] out_mip,
    output logic [63:0] out_mtvec,
    output logic [63:0] out_mepc,
    output logic [63:0] out_mcause,

    output logic [63:0] out_sstatus,
    output logic [63:0] out_stvec,
    output logic [63:0] out_sepc,
    output logic [63:0] out_scause,
    output logic [63:0] out_stval,
    output logic [63:0] out_satp,

    // to Data-Cache
    output logic [PERIPHERAL_CSR_WIDTH-1:0] out_DCACHE_CTRL,

    // to DMA
    output logic [PERIPHERAL_CSR_WIDTH-1:0] out_DMA_CTRL,
    output logic [PERIPHERAL_CSR_WIDTH-1:0] out_DMA_WORDS,
    output logic [PERIPHERAL_CSR_WIDTH-1:0] out_DMA_SRC,
    output logic [PERIPHERAL_CSR_WIDTH-1:0] out_DMA_DST,
    input  logic [63:0] in_DMA_STATUS,

    // to SynapEngine
    output logic [PERIPHERAL_CSR_WIDTH-1:0] out_SA_CTRL,
    output logic [PERIPHERAL_CSR_WIDTH-1:0] out_SA_SIZE,
    input  logic [63:0] in_SA_STATUS,
    output logic [PERIPHERAL_CSR_WIDTH-1:0] out_SA_ADDR_A,
    output logic [PERIPHERAL_CSR_WIDTH-1:0] out_SA_ADDR_B,
    output logic [PERIPHERAL_CSR_WIDTH-1:0] out_SA_ADDR_C,

    // to CPU Monitor
    output logic [PERIPHERAL_CSR_WIDTH-1:0] out_CPU_MON_CTRL,
    input  logic [63:0] in_CPU_MON_CYCLE
);
    // SA ADDRESS (TBD)
    localparam logic [63:0] SA_ADDR_A = 64'h0002_0000;
    localparam logic [63:0] SA_ADDR_B = 64'h0002_0010;
    localparam logic [63:0] SA_ADDR_C = 64'h0002_0020;

    // Privilege level encoding (RISC-V spec)
    localparam logic [1:0] PRIV_U = 2'b00;
    localparam logic [1:0] PRIV_S = 2'b01;
    localparam logic [1:0] PRIV_M = 2'b11;

    // ---------------- Machine CSRs ----------------
    logic [63:0] csr_mstatus;
    logic [63:0] csr_medeleg;
    localparam logic [63:0] CSR_MISA = 64'h8000_0000_0014_1100; // RV64 + I,M,S,U
    logic [63:0] csr_mie;
    logic [63:0] csr_mip;
    logic [63:0] csr_mtvec;
    logic [63:0] csr_mscratch;
    logic [63:0] csr_mepc;
    logic [63:0] csr_mcause;
    logic [63:0] csr_mtval;

    // ---------------- Supervisor CSRs ----------------
    logic [63:0] csr_sstatus;   // ★独立CSR（SIE=bit1 等）
    logic [63:0] csr_sie;       // ★独立CSR（SSIP=1, STIP=5, SEIP=9）
    logic [63:0] csr_stvec;
    logic [63:0] csr_sscratch;
    logic [63:0] csr_sepc;
    logic [63:0] csr_scause;
    logic [63:0] csr_stval;
    logic [63:0] csr_satp;

    logic [1:0] csr_priv_mode;

    // ---------------- DMA CSRs ----------------
    logic [63:0] csr_DCACHE_CTRL;
    logic [63:0] csr_DMA_CTRL;
    logic [63:0] csr_DMA_WORDS;
    logic [63:0] csr_DMA_SRC;
    logic [63:0] csr_DMA_DST;
    logic [63:0] csr_DMA_STATUS;

    // ---------------- SynapEngine CSRs ----------------
    logic [63:0] csr_SA_CTRL;
    logic [63:0] csr_SA_SIZE;
    logic [63:0] csr_SA_STATUS;
    logic [63:0] csr_SA_ADDR_A;
    logic [63:0] csr_SA_ADDR_B;
    logic [63:0] csr_SA_ADDR_C;

    // ---------------- CPU Monitor CSRs ----------------
    logic [63:0] csr_CPU_MON_CTRL;

    // ---------------- constants ----------------
    localparam int S_SIE_BIT  = 1;
    localparam int S_SPIE_BIT = 5;
    localparam int S_SPP_BIT  = 8;
    localparam int S_SUM_BIT  = 18;
    localparam int S_MXR_BIT  = 19;

    localparam logic [63:0] SSTATUS_MASK =
        (64'h1<<S_SIE_BIT) | (64'h1<<S_SPIE_BIT) | (64'h1<<S_SPP_BIT) |
        (64'h1<<S_SUM_BIT) | (64'h1<<S_MXR_BIT);

    // M IRQ
    localparam logic [63:0] MSIP_MASK = (64'h1<<3);
    localparam logic [63:0] MTIP_MASK = (64'h1<<7);
    localparam logic [63:0] MEIP_MASK = (64'h1<<11);
    localparam logic [63:0] MIRQ_MASK = MSIP_MASK | MTIP_MASK | MEIP_MASK;

    // S IRQ
    localparam logic [63:0] SSIP_MASK = (64'h1<<1);
    localparam logic [63:0] STIP_MASK = (64'h1<<5);
    localparam logic [63:0] SEIP_MASK = (64'h1<<9);
    localparam logic [63:0] SIRQ_MASK = SSIP_MASK | STIP_MASK | SEIP_MASK;

    // ---------------- helpers ----------------
    function automatic logic [63:0] pack_tvec_direct(input logic [63:0] v);
        begin pack_tvec_direct = {v[63:2], 2'b00}; end
    endfunction
    function automatic logic [63:0] pack_epc(input logic [63:0] v);
      begin pack_epc = {v[63:2], 2'b00}; end   // 下位2bitゼロ固定
    endfunction
    // sip view（mip -> sip）
    function automatic logic [63:0] sip_view(input logic [63:0] mip);
        logic [63:0] v;
        begin
            v = 64'b0;
            v[1] = mip[3];   // SSIP <- MSIP
            v[5] = mip[7];   // STIP <- MTIP
            v[9] = mip[11];  // SEIP <- MEIP
            sip_view = v;
        end
    endfunction

    // CSR apply (RW/RS/RC)
    logic [63:0] csr_wr_val;
    logic side_effect_none_rs;

    assign csr_wr_val =
        csr_use_imm ? {59'b0, csr_zimm} : csr_rs1_val;
    assign side_effect_none_rs =
        csr_use_imm ? (csr_zimm == 5'd0) : (csr_rs1_val == 64'd0);

    function automatic logic [63:0] csr_apply(
        input logic [1:0] cmd,
        input logic no_side_effect_rs,
        input logic [63:0] oldv,
        input logic [63:0] wv
    );
        begin
            case (cmd)
                2'b00: csr_apply = wv;                                   // RW
                2'b01: csr_apply = no_side_effect_rs ? oldv : (oldv |  wv); // RS
                2'b10: csr_apply = no_side_effect_rs ? oldv : (oldv & ~wv); // RC
                default: csr_apply = oldv;
            endcase
        end
    endfunction

    logic trap_to_s;

    // Decode the cause in parallel instead of putting a variable 64:1 mux
    // after the trap-cause priority encoder.  Preserve every delegation bit.
    (* keep = "true" *) wire [63:0] delegated_cause;
    genvar cause_bit;
    generate
        for (cause_bit = 0; cause_bit < 64; cause_bit = cause_bit + 1) begin : g_delegated_cause
            assign delegated_cause[cause_bit] =
                (trap_scause[5:0] == 6'(cause_bit)) && csr_medeleg[cause_bit];
        end
    endgenerate
    assign trap_to_s =
        (priv_mode != PRIV_M) && !(|trap_scause[63:6]) && (|delegated_cause);

    // ---------------- outputs ----------------
    // The CSR registers are already the architectural state.  Driving a
    // second bank of output flops duplicated hundreds of bits and created a
    // global csr_valid clock-enable network.  Expose the state directly and
    // retain registers only for status inputs that must be sampled.
    always_comb begin
        out_mstatus = csr_mstatus;
        out_medeleg = csr_medeleg;
        out_mie     = csr_mie;
        out_mip     = csr_mip;
        out_mtvec   = csr_mtvec;
        out_mepc    = csr_mepc;
        out_mcause  = csr_mcause;

        out_sstatus = csr_sstatus;
        out_stvec   = csr_stvec;
        out_sepc    = csr_sepc;
        out_scause  = csr_scause;
        out_stval   = csr_stval;
        out_satp    = csr_satp;
        priv_mode   = csr_priv_mode;

        out_DCACHE_CTRL = PERIPHERAL_CSR_WIDTH'(csr_DCACHE_CTRL);
        out_DMA_CTRL    = PERIPHERAL_CSR_WIDTH'(csr_DMA_CTRL);
        out_DMA_WORDS   = PERIPHERAL_CSR_WIDTH'(csr_DMA_WORDS);
        out_DMA_SRC     = PERIPHERAL_CSR_WIDTH'(csr_DMA_SRC);
        out_DMA_DST     = PERIPHERAL_CSR_WIDTH'(csr_DMA_DST);
        out_SA_CTRL     = PERIPHERAL_CSR_WIDTH'(csr_SA_CTRL);
        out_SA_SIZE     = PERIPHERAL_CSR_WIDTH'(csr_SA_SIZE);
        out_SA_ADDR_A   = PERIPHERAL_CSR_WIDTH'(csr_SA_ADDR_A);
        out_SA_ADDR_B   = PERIPHERAL_CSR_WIDTH'(csr_SA_ADDR_B);
        out_SA_ADDR_C   = PERIPHERAL_CSR_WIDTH'(csr_SA_ADDR_C);
        out_CPU_MON_CTRL = PERIPHERAL_CSR_WIDTH'(csr_CPU_MON_CTRL);
    end

    always_ff @(posedge clock or negedge reset_n) begin
        if (!reset_n) begin
            csr_DMA_STATUS <= 64'd0;
            csr_SA_STATUS  <= 64'd0;
        end else if (csr_valid) begin
            csr_DMA_STATUS <= in_DMA_STATUS;
            csr_SA_STATUS  <= in_SA_STATUS;
        end
    end

    // ---------------- read mux ----------------
    // PIPELINED_READ=1 has two registered stages: address decode, then
    // partial data selection. The consumer must hold the address for two
    // edges before capturing csr_rdata. CSR serialization keeps architectural
    // state stable; peripheral status is sampled at the data-selection edge.
    (* keep = "true" *) wire [21:0] csr_read_decode;
    assign csr_read_decode[0] = (csr_read_addr == 12'h100);
    assign csr_read_decode[1] = (csr_read_addr == 12'h104);
    assign csr_read_decode[2] = (csr_read_addr == 12'h105);
    assign csr_read_decode[3] = (csr_read_addr == 12'h140);
    assign csr_read_decode[4] = (csr_read_addr == 12'h141);
    assign csr_read_decode[5] = (csr_read_addr == 12'h142);
    assign csr_read_decode[6] = (csr_read_addr == 12'h143);
    assign csr_read_decode[7] = (csr_read_addr == 12'h144);
    assign csr_read_decode[8] = (csr_read_addr == 12'h180);
    assign csr_read_decode[9] = (csr_read_addr == 12'h300);
    assign csr_read_decode[10] = (csr_read_addr == 12'h301);
    assign csr_read_decode[11] = (csr_read_addr == 12'h302);
    assign csr_read_decode[12] = (csr_read_addr == 12'h304);
    assign csr_read_decode[13] = (csr_read_addr == 12'h305);
    assign csr_read_decode[14] = (csr_read_addr == 12'h340);
    assign csr_read_decode[15] = (csr_read_addr == 12'h341);
    assign csr_read_decode[16] = (csr_read_addr == 12'h342);
    assign csr_read_decode[17] = (csr_read_addr == 12'h343);
    assign csr_read_decode[18] = (csr_read_addr == 12'h344);
    assign csr_read_decode[19] = (csr_read_addr == 12'h7F0);
    assign csr_read_decode[20] = (csr_read_addr == 12'h7C8);
    assign csr_read_decode[21] = (csr_read_addr == 12'hBC4);
    wire [21:0] csr_read_select;
    generate
        if (PIPELINED_READ != 0) begin : g_read_pipeline
            logic [21:0] select_q;
            logic [63:0] group0_q, group1_q, group2_q, group3_q;
            always_ff @(posedge clock or negedge reset_n) begin
                if (!reset_n) begin
                    select_q <= '0;
                    group0_q <= '0;
                    group1_q <= '0;
                    group2_q <= '0;
                    group3_q <= '0;
                end else begin
                    select_q <= csr_read_decode;
                    group0_q <=
                        ({64{select_q[0]}} & (((csr_sstatus & SSTATUS_MASK) | 64'h0000_0002_0000_0000))) |
                        ({64{select_q[1]}} & ((csr_sie     & SIRQ_MASK))) |
                        ({64{select_q[2]}} & (csr_stvec)) |
                        ({64{select_q[3]}} & (csr_sscratch)) |
                        ({64{select_q[4]}} & (csr_sepc)) |
                        ({64{select_q[5]}} & (csr_scause));
                    group1_q <=
                        ({64{select_q[6]}} & (csr_stval)) |
                        ({64{select_q[7]}} & (sip_view(csr_mip))) |
                        ({64{select_q[8]}} & (csr_satp)) |
                        ({64{select_q[9]}} & (csr_mstatus)) |
                        ({64{select_q[10]}} & (CSR_MISA)) |
                        ({64{select_q[11]}} & (csr_medeleg));
                    group2_q <=
                        ({64{select_q[12]}} & ((csr_mie & MIRQ_MASK))) |
                        ({64{select_q[13]}} & (csr_mtvec)) |
                        ({64{select_q[14]}} & (csr_mscratch)) |
                        ({64{select_q[15]}} & (csr_mepc)) |
                        ({64{select_q[16]}} & (csr_mcause)) |
                        ({64{select_q[17]}} & (csr_mtval));
                    group3_q <=
                        ({64{select_q[18]}} & ((csr_mip & MIRQ_MASK))) |
                        ({64{select_q[19]}} & (csr_DMA_STATUS)) |
                        ({64{select_q[20]}} & (csr_SA_STATUS)) |
                        ({64{select_q[21]}} & (in_CPU_MON_CYCLE));
                end
            end
            assign csr_read_select = select_q;
            assign csr_rdata = group0_q | group1_q | group2_q | group3_q;
        end else begin : g_read_comb
            assign csr_read_select = csr_read_decode;
            assign csr_rdata =
                ({64{csr_read_select[0]}} & (((csr_sstatus & SSTATUS_MASK) | 64'h0000_0002_0000_0000))) |
                ({64{csr_read_select[1]}} & ((csr_sie     & SIRQ_MASK))) |
                ({64{csr_read_select[2]}} & (csr_stvec)) |
                ({64{csr_read_select[3]}} & (csr_sscratch)) |
                ({64{csr_read_select[4]}} & (csr_sepc)) |
                ({64{csr_read_select[5]}} & (csr_scause)) |
                ({64{csr_read_select[6]}} & (csr_stval)) |
                ({64{csr_read_select[7]}} & (sip_view(csr_mip))) |
                ({64{csr_read_select[8]}} & (csr_satp)) |
                ({64{csr_read_select[9]}} & (csr_mstatus)) |
                ({64{csr_read_select[10]}} & (CSR_MISA)) |
                ({64{csr_read_select[11]}} & (csr_medeleg)) |
                ({64{csr_read_select[12]}} & ((csr_mie & MIRQ_MASK))) |
                ({64{csr_read_select[13]}} & (csr_mtvec)) |
                ({64{csr_read_select[14]}} & (csr_mscratch)) |
                ({64{csr_read_select[15]}} & (csr_mepc)) |
                ({64{csr_read_select[16]}} & (csr_mcause)) |
                ({64{csr_read_select[17]}} & (csr_mtval)) |
                ({64{csr_read_select[18]}} & ((csr_mip & MIRQ_MASK))) |
                ({64{csr_read_select[19]}} & (csr_DMA_STATUS)) |
                ({64{csr_read_select[20]}} & (csr_SA_STATUS)) |
                ({64{csr_read_select[21]}} & (in_CPU_MON_CYCLE));
        end
    endgenerate

    // ---------------- main ----------------
    //reg [63:0] oldv, newv;
    logic [63:0] oldv, newv;

    // Read the CSR before commit and register it in the pipeline.  This keeps
    // the address decoder and the read mux out of the commit-stage CSR update
    // and register-file write-back paths.

    assign  oldv = csr_old_value;
    assign  newv = csr_apply(csr_cmd, side_effect_none_rs, oldv, csr_wr_val);

    always_ff @(posedge clock or negedge reset_n) begin
        if (!reset_n) begin
            //oldv          <= 32'h0;
            //newv          <= 32'h0;
            csr_priv_mode   <= PRIV_M;
            // M
            csr_mstatus   <= 64'h0000_000A_0000_1800; // MPP=M-mode, IE=OFF
            //csr_mstatus   <= 32'h00000000;
            csr_medeleg   <= 64'b0;
            csr_mie       <= 64'b0;
            csr_mtvec     <= 64'b0;
            csr_mscratch  <= 64'b0;
            csr_mepc      <= 64'b0;
            csr_mcause    <= 64'b0;
            csr_mtval     <= 64'b0;
            csr_mip       <= 64'b0;
            // S
            csr_sstatus   <= 64'h0000_0002_0000_0000;
            csr_sie       <= 64'b0;
            csr_stvec     <= 64'b0;
            csr_sscratch  <= 64'b0;
            csr_sepc      <= 64'b0;
            csr_scause    <= 64'b0;
            csr_stval     <= 64'b0;
            csr_satp      <= 64'b0;
            // Data Cache
            csr_DCACHE_CTRL <= 64'b0;
            // DMA
            csr_DMA_CTRL    <= 64'b0;
            csr_DMA_WORDS   <= 64'b0;
            csr_DMA_SRC     <= 64'b0;
            csr_DMA_DST     <= 64'b0;
            // SA
            csr_SA_CTRL     <= 64'b0;
            csr_SA_SIZE     <= 64'b0;
            csr_SA_ADDR_A   <= SA_ADDR_A;
            csr_SA_ADDR_B   <= SA_ADDR_B;
            csr_SA_ADDR_C   <= SA_ADDR_C;
            // MONITOR
            csr_CPU_MON_CTRL <= 64'b0;

        end else begin
            // ---- CSR writes ----
            if (csr_wr & csr_enb) begin
                //oldv = csr_read_mux(csr_addr);
                //newv = csr_apply(csr_cmd, side_effect_none_rs, oldv, csr_wr_val);

                case (csr_addr)
                    // ===== Supervisor =====
                    12'h100: csr_sstatus  <= (newv & SSTATUS_MASK);   // sstatus
                    12'h104: csr_sie      <= (newv & SIRQ_MASK);      // sie
                    12'h105: csr_stvec    <= pack_tvec_direct(newv);  // stvec
                    12'h140: csr_sscratch <= newv;
                    12'h141: csr_sepc     <= pack_epc(newv);
                    12'h142: csr_scause   <= newv;
                    12'h143: csr_stval    <= newv;
                    // sip write: SSIPのみ可 → mip[MSIP]へ反映
                    12'h144: begin
                        if (!side_effect_none_rs) csr_mip[3] <= newv[1];
                    end
                    // Sv39 uses all 44 PPN bits; ASIDs are retained even though
                    // the walker has no TLB. Unsupported MODE writes have no effect.
                    12'h180: begin
                        if (newv[63:60] == 4'd0)
                            csr_satp <= 64'b0;
                        else if (newv[63:60] == 4'd8)
                            csr_satp <= newv;
                    end

                    // ===== Machine =====
                    12'h300: csr_mstatus  <= (newv & ~64'h0000_000F_0000_0000) | 64'h0000_000A_0000_0000;                    // mstatus
                    12'h302: csr_medeleg <= newv;                     // medeleg
                    12'h301: /* misa: RO */;
                    12'h304: csr_mie      <= (newv & MIRQ_MASK);
                    12'h305: csr_mtvec    <= pack_tvec_direct(newv);
                    12'h340: csr_mscratch <= newv;
                    12'h341: csr_mepc     <= pack_epc(newv);
                    12'h342: csr_mcause   <= newv;
                    12'h343: csr_mtval    <= newv;
                    12'h344: csr_mip      <= (newv & MIRQ_MASK);

                    // ===== DATA CACHE =====
                    12'h7F0: csr_DCACHE_CTRL <= newv;

                    // ===== DMA =====
                    12'h7E0: csr_DMA_CTRL   <= newv;
                    12'h7E4: csr_DMA_WORDS  <= newv;
                    12'h7E8: csr_DMA_SRC    <= newv;
                    12'h7EC: csr_DMA_DST    <= newv;

                    // ===== SynapEngine =====
                    12'h7C0: csr_SA_CTRL    <= newv;
                    12'h7C4: csr_SA_SIZE    <= newv;
                    // 7C8: csr_SA_STATUS
                    12'h7D0: csr_SA_ADDR_A  <= newv;
                    12'h7D4: csr_SA_ADDR_B  <= newv;
                    12'h7D8: csr_SA_ADDR_C  <= newv;

                    // ===== CPU MONITOR =====
                    12'hBC0: csr_CPU_MON_CTRL <= newv;

                    default: ;
                endcase
            end

            // Faults are not normal commits.  Accept the trap event directly;
            // ecall and illegal-instruction still arrive with csr_enb asserted.
            if (set_trap) begin
                        if (trap_to_s) begin
                            // ---- S trap ----
                            csr_priv_mode  <= PRIV_S;

                            csr_sepc   <= pack_epc(trap_sepc);
                            csr_scause <= trap_scause;
                            csr_stval  <= trap_stval;

                            csr_sstatus[S_SPIE_BIT] <= csr_sstatus[S_SIE_BIT];
                            csr_sstatus[S_SIE_BIT]  <= 1'b0;
                            csr_sstatus[S_SPP_BIT]  <= priv_mode[0];

                        end else begin
                            // ---- M trap ----
                            csr_priv_mode  <= PRIV_M;

                            csr_mepc   <= pack_epc(trap_sepc);
                            csr_mcause <= trap_scause;
                            csr_mtval  <= trap_stval;

                            csr_mstatus[7]     <= csr_mstatus[3];   // MPIE <- MIE
                            csr_mstatus[3]     <= 1'b0;             // MIE  <- 0
                            csr_mstatus[12:11] <= priv_mode;        // MPP  <- 元のモード
                        end
            end

            if (csr_enb) begin
                // ---- Supervisor trap in/out (SRET) ----
                if (do_sret) begin
                    csr_priv_mode <= {1'b0, csr_sstatus[S_SPP_BIT]}; // 0 or 1
                    csr_sepc   <= pack_epc(csr_sepc);
                    csr_sstatus[S_SIE_BIT]  <= csr_sstatus[S_SPIE_BIT];
                    csr_sstatus[S_SPIE_BIT] <= 1'b1;
                    csr_sstatus[S_SPP_BIT]  <= 1'b0;
                end

                // ---- Machine trap in/out ----
                if (do_mret) begin
                    // 特権遷移
                    csr_priv_mode <= csr_mstatus[12:11];

                    // mstatus の更新（あなたの既存コードに追加）
                    csr_mstatus[3]  <= csr_mstatus[7];  // MIE  <- MPIE
                    csr_mstatus[7]  <= 1'b1;            // MPIE <- 1
                    csr_mstatus[12:11] <= 2'b00;        // ★ MPP <- U (必須)
                end
            end

            // Machine interrupts are accepted at a precise pipeline boundary,
            // where there is no committing CSR instruction and csr_enb is low.
            // Therefore trap entry must not be gated by the CSR commit enable.
            if (set_mtrap) begin
                csr_priv_mode       <= PRIV_M;
                csr_mepc            <= pack_epc(trap_mepc);
                csr_mcause          <= trap_mcause;
                csr_mstatus[7]      <= csr_mstatus[3]; // MPIE <- MIE
                csr_mstatus[3]      <= 1'b0;           // MIE  <- 0
                csr_mstatus[12:11]  <= priv_mode;      // MPP  <- prior mode
            end

            // ---- mip pending ----
            if (set_msip)  csr_mip[3]  <= 1'b1;
            if (clr_msip)  csr_mip[3]  <= 1'b0;
            if (set_mtip)  csr_mip[7]  <= 1'b1;
            if (clr_mtip)  csr_mip[7]  <= 1'b0;
            if (set_meip)  csr_mip[11] <= 1'b1;
            if (clr_meip)  csr_mip[11] <= 1'b0;
        end
    end
endmodule
